atthorv/Sensobar-48HD_6L/slave_board/Project Outputs for Netscale48HD_Sensorbar/BOM_S.xls

Designator | Value | Description | Manufacturer PartNr | Footprint/Package | Replaceable | Quantity
C1, C3, C5, C7, C9, C21 | 10nF | 10000pF ±10% 50V Keramikkondensatoren X7R 0402 (1005 metrisch) CL05B103KB5NNNC | CL05B103KB5NNNC | '0402 | yes | 6
C2, C4, C6, C8, C10, C19, C20 | 2.2uF | Multilayer Ceramic Capacitors MLCC - SMD/SMT 0402 2.2uF 6.3volts *Derate Voltage/Temp, 2.2µF ±20% 25V Ceramic Capacitor X5R 0402 (1005 Metric), Multilayer Ceramic Capacitors MLCC - SMD/SMT 0402 2.2uF 6.3volts | GRM155R60J225ME15D | 0402 | yes | 7
C11 | 10pF | Multilayer Ceramic Capacitors MLCC - SMD/SMT 0402 10pF 50Volts C0G 1% | GJM1555C1H100FB01D | '0402 | yes | 1
C12, C16, C17 | 3.3nF | Multilayer Ceramic Capacitors MLCC - SMD/SMT 0402 3300pF 50volts X7R 5% | GCM155R71H332JA37D | '0402 | yes | 3
C13, C14 | 15pF | Multilayer Ceramic Capacitors MLCC - SMD/SMT 0402 15pF 50Volts C0G 5%, Multilayer Ceramic Capacitors MLCC | GJM1555C1H150FB01D | '0402 | yes | 2
C15, C18 | 1.2nF | Multilayer Ceramic Capacitors MLCC - SMD/SMT 50V 1200pF C0G 0402 5% | C0402C122J5GACTU | '0402 | yes | 2
C28_A, C28_B, C28_C, C30_A, C30_B, C30_C | 100nF | 0.1µF ±10% 10V Ceramic Capacitor X5R 0402 (1005 Metric) | LMK105BJ104KV-F | '0402 | yes | 6
C31_A, C31_B, C31_C, C32_A, C32_B, C32_C, C37_A, C37_B, C37_C, C39_A, C39_B, C39_C, C46_A, C46_B, C46_C, C53_A, C53_B, C53_C, C60_A, C60_B, C60_C, C67_A, C67_B, C67_C | 220pF | 220pF ±1% 50V Ceramic Capacitor C0G, NP0 0402 (1005 Metric) | GRM033R71E122KA01D | '0402 | yes | 24
C33_A, C33_B, C33_C, C35_A, C35_B, C35_C, C38_A, C38_B, C38_C, C42_A, C42_B, C42_C, C49_A, C49_B, C49_C, C56_A, C56_B, C56_C, C63_A, C63_B, C63_C, C70_A, C70_B, C70_C | 150pF | 150pF ±1% 50V Ceramic Capacitor C0G, NP0 0402 (1005 Metric) | GRM1555C1H151FA01D | '0402 | yes | 24
C34_A, C34_B, C34_C, C36_A, C36_B, C36_C, C40_A, C40_B, C40_C, C43_A, C43_B, C43_C, C50_A, C50_B, C50_C, C57_A, C57_B, C57_C, C64_A, C64_B, C64_C, C71_A, C71_B, C71_C | 4.7pF | 4.7pF ±0.05pF 50V Ceramic Capacitor C0G, NP0 0402 (1005 Metric) | GJM1555C1H4R7WB01D | '0402 | yes | 24
FB1 |  | FERRITE BEAD 1 KOHM 0402 1LN | BK1005HS102-T | '0402 | no | 1
J3 |  | Connector,Board to Board,DF12 Hirose DF12 Series 0.5mm 20 Way 2 Row Straight PCB Socket Surface Mount Board to Board | DF12-20DS-0.5V(86) |  | no | 1
L1, L2 | 100nH | 100nH Unshielded Multilayer Inductor 300mA 100 mOhm Max 0603 (1608 Metric) | HK1608R10J-T | 0603 | no | 2
LED1_A, LED1_B, LED1_C, LED2_A, LED2_B, LED2_C, LED3_A, LED3_B, LED3_C, LED4_A, LED4_B, LED4_C, LED5_A, LED5_B, LED5_C, LED6_A, LED6_B, LED6_C, LED7_A, LED7_B, LED7_C, LED8_A, LED8_B, LED8_C |  | Red 630nm LED Indication - Discrete 1.95V 2-SMD, No Lead | APA1606SURCK | 0402 | yes | 24
R1, R2, R3 | 1K | RES SMD 1K OHM 1% 1/16W 0402 | RC0402FR-071KL | 0402 | yes | 3
R4, R5 | 10K | SMD 10K ohm 1% 50V General Purpose | RC0402FR-1010KL | 0402 | yes | 2
R6_A, R6_B, R6_C, R7_A, R7_B, R7_C, R10_A, R10_B, R10_C, R11_A, R11_B, R11_C, R12_A, R12_B, R12_C, R13_A, R13_B, R13_C, R14_A, R14_B, R14_C, R15_A, R15_B, R15_C | 68R | 68 Ohms ±1% 0.125W, 1/8W Chip Resistor 0402 (1005 Metric) Pulse Withstanding Thick Film | CRGP0402F68R | 0402 | yes | 24
R8_A, R8_B, R8_C, R9_A, R9_B, R9_C, R17_A, R17_B, R17_C, R19_A, R19_B, R19_C, R21_A, R21_B, R21_C, R23_A, R23_B, R23_C, R25_A, R25_B, R25_C, R27_A, R27_B, R27_C | 620 | 620 Ohms ±1% 0.1W, 1/10W Chip Resistor 0402 (1005 Metric) Automotive AEC-Q200 Thick Film | ERJ-2RKF6200X | 0402 | yes | 24
U1 |  | TRF7960ARHBT | TRF7960ARHBT |  | no | 1
U3_A, U3_B, U3_C |  | IC 8BIT SHIFT REGISTER 16HVQFN | 74AHC595BQ,115 |  | no | 3
U4_A, U4_B, U4_C |  | Multiplexer Switch ICs Sngl-Pole Dbl-Throw Analog Switch | SN74CBTLV3251RGYR | VQFN-16 | no | 3
U5_A, U5_B, U5_C, U6_A, U6_B, U6_C, U7_A, U7_B, U7_C, U9_A, U9_B, U9_C, U11_A, U11_B, U11_C, U13_A, U13_B, U13_C, U15_A, U15_B, U15_C, U17_A, U17_B, U17_C |  | antenna |  |  | no | 24
Y1 |  | 13.56MHz ±10ppm Crystal 12pF 150 Ohms 4-SMD, No Lead | CX2520DB13560H0FLJC1 |  | no | 1
