atthorv/Sensobar-48HD_6L/master_board/Project Outputs for Netscale48HD_Sensorbar/BOM_M.xls

Designator | Value | Description | Manufacturer PartNr | Footprint/Package | Replaceable | Quantity
C1, C3, C5, C7, C9, C21 | 10nF | 10000pF ±10% 50V Keramikkondensatoren X7R 0402 (1005 metrisch) CL05B103KB5NNNC | CL05B103KB5NNNC | 0402 | yes | 6
C2, C4, C6, C8, C10, C22, C59, C85, C86, C87 | 2.2uF | Multilayer Ceramic Capacitors MLCC - SMD/SMT 0402 2.2uF 6.3volts *Derate Voltage/Temp, 2.2µF ±20% 25V Ceramic Capacitor X5R 0402 (1005 Metric) | GRM155R60J225ME15D | 0402 | yes | 10
C11 | 10pF | Multilayer Ceramic Capacitors MLCC - SMD/SMT 0402 10pF 50Volts C0G 1% | GJM1555C1H100FB01D | 0402 (1005 metric) | yes | 1
C12, C16, C17 | 3.3nF | Multilayer Ceramic Capacitors MLCC - SMD/SMT 0402 3300pF 50volts X7R 5% | GCM155R71H332JA37D | 0402 (1005 metric) | yes | 3
C13, C14, C54, C55 | 15pF | Multilayer Ceramic Capacitors MLCC - SMD/SMT 0402 15pF 50Volts C0G 5%, Multilayer Ceramic Capacitors MLCC | GJM1555C1H150FB01D | 0402 | no | 4
C15, C18 | 1.2nF | Multilayer Ceramic Capacitors MLCC - SMD/SMT 50V 1200pF C0G 0402 5% | C0402C122J5GACTU | 0402 (1005 metric) | yes | 2
C19, C20, C23, C24, C25, C27, C29, C44, C51, C52, C58, C62, C66, C76, C77, C78, C79, C80, C81, C82, C83, C88 | 0.1uF | SMD/SMT WCAP-CSGP 0.1uF 0402 20% 10V MLCC | 885012105010 | 0402 | yes | 22
C26 | 0.1uF | SMD/SMT WCAP-CSGP 0.1uF 0402 20% 10V MLCC | 885012105010 | 0402 | yes | 1
C28_A, C28_B, C28_C, C30_A, C30_B, C30_C | 100nF | 0.1µF ±10% 10V Ceramic Capacitor X5R 0402 (1005 Metric) | LMK105BJ104KV-F | 0402 | yes | 6
C31_A, C31_B, C31_C, C32_A, C32_B, C32_C, C37_A, C37_B, C37_C, C39_A, C39_B, C39_C, C46_A, C46_B, C46_C, C53_A, C53_B, C53_C, C60_A, C60_B, C60_C, C67_A, C67_B, C67_C | 220pF | 220pF ±1% 50V Ceramic Capacitor C0G, NP0 0402 (1005 Metric) | GRM033R71E122KA01D | 0402 | yes | 24
C33_A, C33_B, C33_C, C35_A, C35_B, C35_C, C38_A, C38_B, C38_C, C42_A, C42_B, C42_C, C49_A, C49_B, C49_C, C56_A, C56_B, C56_C, C63_A, C63_B, C63_C, C70_A, C70_B, C70_C | 150pF | 150pF ±1% 50V Ceramic Capacitor C0G, NP0 0402 (1005 Metric) | GRM1555C1H151FA01D | 0402 | yes | 24
C34_A, C34_B, C34_C, C36_A, C36_B, C36_C, C40_A, C40_B, C40_C, C43_A, C43_B, C43_C, C50_A, C50_B, C50_C, C57_A, C57_B, C57_C, C64_A, C64_B, C64_C, C71_A, C71_B, C71_C | 4.7pF | 4.7pF ±0.05pF 50V Ceramic Capacitor C0G, NP0 0402 (1005 Metric) | GJM1555C1H4R7WB01D | 0402 | yes | 24
C41, C45 | 1uF | SMD/SMT 0402 1uF 10volts X7S 10% | GCM155C71A105KE38D | 0402 (1005 metric) | yes | 2
C47, C48 | 11pF | SMD/SMT 0402 11pF 50volts C0G 5% | GRM1555C1H110JA01D | 0402 | yes | 2
C61 | 1nF | 1000pF ±20% 50V Ceramic Capacitor X5R 0402 (1005 Metric) | C1005X5R1H102M050BA | 0402 | yes | 1
C65 | 10uF | Multilayer Ceramic Capacitors MLCC - SMD/SMT | ZRB15XR61A106ME01D | 0402 | yes | 1
C68, C69 | 470nF | 470nF, 100V, X7R, 10 %, Chip Monolithic Ceramic Capacitor for General, 0805 (metric 2012) | GRM21BR72A474KA73L | 0805 | yes | 2
C72 | 10uF | Chip Capacitor, 10 uF, +/- 20%, 100 V, -55 to 125 degC, 2220 (5750 Metric), RoHS, Tape and Reel |  | 2220 |  | 1
C73 | 100uF | Multilayer Ceramic Capacitors MLCC - SMD/SMT 1210 100uF 10volts *Derate Voltage/Temp | GRM32ER61A107ME20L | 1210 | yes | 1
C75, C84 | 4.7uF | SMD/SMT 0603 4.7uF 10volts | GRM188R61A475KE15D | 0603 | yes | 2
D1 | SMAJ51A | ESD Suppressors / TVS Diodes 51volts 5uA 4.9 Amps Uni-Dir | SMAJ51A | DO-214AC-2 (SMA) | yes | 1
D4, D5 |  | Thyristor Surge Protection Devices (TSPD) PxxxxS4xLRP Series SIDACtor Protection Thyristor 100A 25V Bi SOD | P0080S4BLRP | SOD-123FL | no | 2
D6 | CDSOT23-SM712 | Surface Mount TVS Diode, 17 A Ipp, -55 to 150 degC, 3-Pin SOT23, RoHS, Tape and Reel |  | DO-214AC-2 (SMA) | no | 1
D7 |  | 15MQ060N SCHOTTKY RECTIFIER | 15MQ060N |  |  | 1
FB1 |  | FERRITE BEAD 1 KOHM 0402 1LN | BK1005HS102-T |  |  | 1
J1 |  | Headers & Wire Housings 6P 1.27MM SNGL ROW R/A MALE BLK | 214013 | 1.27mm | no | 1
J2 |  | Connector,Board to Board,DF12 Hirose DF12 Series, 0.5mm Pitch 20 Way 2 Row Straight PCB Header, Solder Termination, 0.3A |  |  | no | 1
L1, L2 | 100nH | 100nH Unshielded Multilayer Inductor 300mA 100 mOhm Max 0603 (1608 Metric) | HK1608R10J-T | 0603 | yes | 2
L5, L6, L7, L8 |  | Chip Ferrite Bead | BLM18KG601SN1D |  | no | 4
L9 | 600R(Z) | Ferritperlen MULTILYR CHP BD 0603 600OHMS 25% | BK1608HS601-T | 0603 | yes | 1
L10 |  | 6.8uH, WE-MAIA SMD Power Inductor | 78438357068 |  |  | 1
LED1_A, LED1_B, LED1_C, LED2_A, LED2_B, LED2_C, LED3_A, LED3_B, LED3_C, LED4_A, LED4_B, LED4_C, LED5_A, LED5_B, LED5_C, LED6_A, LED6_B, LED6_C, LED7_A, LED7_B, LED7_C, LED8_A, LED8_B, LED8_C |  | Red 630nm LED Indication - Discrete 1.95V 2-SMD, No Lead | APA1606SURCK |  | no | 24
LED9 |  | blue, 1.6 x 0.6 mm Right Angle SMD Chip LED Lamp | APA1606VBC/D | specific, see datasheet | yes | 1
P1 |  | 20Pin, 2Rows, side/horizontally, MICRO LOW-PROFILE TERMINAL STRIPS | FTSH-110-01-F-DH | 1.27 mm | no | 1
P2 |  | 6Pin, 2Rows, MICRO LOW-PROFILE TERMINAL STRIPS | FTSH-103-01-F-DH | 1.27 mm | no | 1
P3, P4 |  | Segger, J-Link 10-pin Needle Adapter |  |  | no | 2
P5 |  | Pad_1mmx2mm | Pad_1mmx2mm |  | no | 1
R1, R2, R3 | 1K | RES SMD 1K OHM 1% 1/16W 0402 | RC0402FR-071KL | 0402 | yes | 3
R4 | DNP | Resistor: do not populate | do not populate | 0402 | no | 1
R5 | 10K | 10K 0.063W 1% 0402 (1005 Metric) SMD | RC0402FR-0710KL | 0402 | yes | 1
R6_A, R6_B, R6_C, R7_A, R7_B, R7_C, R10_A, R10_B, R10_C, R11_A, R11_B, R11_C, R12_A, R12_B, R12_C, R13_A, R13_B, R13_C, R14_A, R14_B, R14_C, R15_A, R15_B, R15_C | 68R | 68 Ohms ±1% 0.125W, 1/8W Chip Resistor 0402 (1005 Metric) Pulse Withstanding Thick Film | CRGP0402F68R | 0402 | yes | 24
R8_A, R8_B, R8_C, R9_A, R9_B, R9_C, R17_A, R17_B, R17_C, R19_A, R19_B, R19_C, R21_A, R21_B, R21_C, R23_A, R23_B, R23_C, R25_A, R25_B, R25_C, R27_A, R27_B, R27_C | 620 | 620 Ohms ±1% 0.1W, 1/10W Chip Resistor 0402 (1005 Metric) Automotive AEC-Q200 Thick Film | ERJ-2RKF6200X | 0402 | yes | 24
R16, R30, R32 | 0R | 0 Ohms Resistor 0402, 0 Ohms Jumper 0.1W, 1/10W Chip Resistor 0402 (1005 Metric) Automotive AEC-Q200 Thick Film | ERJ-2GE0R00X | 0402 (1005 metric) | yes | 3
R18, R35 | 1K | Thick Film Resistors - SMD CRGCQ 0402 1K0 1% SMD Resistor | CRGCQ0402F1K0 | 0402 (1005 metric) | yes | 2
R20, R22, R24, R26, R28, R33, R41, R42 | 10K | SMD 10K ohm 1% 50V General Purpose | RC0402FR-1010KL | 0402 | yes | 8
R29, R34 | 10 | 10R, Pulse Proof, High Power Thick Film Chip Resistors | CRCW060310R0FKEAHP | 0603 |  | 2
R31 | 120R | 120 Ohms ±1% 0.063W, 1/16W Chip Resistor 0402 (1005 Metric) Automotive AEC-Q200, Moisture Resistant Thick Film | CRGCQ0402F120R | 0402 | yes | 1
R36 | 60K4 | 60.4 kOhms ±1% 0.063W, 1/16W Chip Resistor 0402 (1005 Metric) Moisture Resistant Thick Film | RC0402FR-0760K4L | 0402 |  | 1
R38 | 100K | 100 kOhm Resistor 0402 | CRCW0402100KJNEDC | 0402 | yes | 1
R39 | 51R | Resistor | RC0402JR-0751RL | 0402 | yes | 1
R40 | 620R | SMD 1/16W 620ohm 0.5% | RR0510P-621-D | 0402 | yes | 1
TVS1 | TBU-PL060-200-WH | TBU-PL Series dual 50 ohm Surge Suppressors, bi-directional | TBU-PL060-200-WH | DFN | no | 1
U1 |  | TRF7960ARHBT | TRF7960ARHBT |  |  | 1
U2 |  | STM32 Dynamic Efficiency MCU with BAM, High-performance and DSP with FPU, ARM Cortex-M4 MCU with 512 Kbytes Flash, 100 MHz CPU, Art Accelerator, DFSDM | STM32F412VEH6 | UFBGA-100 | no | 1
U3_A, U3_B, U3_C |  | IC 8BIT SHIFT REGISTER 16HVQFN | 74AHC595BQ,115 |  | no | 3
U4_A, U4_B, U4_C |  | Multiplexer Switch ICs Sngl-Pole Dbl-Throw Analog Switch | SN74CBTLV3251RGYR | VQFN-16 | no | 3
U5_A, U5_B, U5_C, U6_A, U6_B, U6_C, U7_A, U7_B, U7_C, U9_A, U9_B, U9_C, U11_A, U11_B, U11_C, U13_A, U13_B, U13_C, U15_A, U15_B, U15_C, U17_A, U17_B, U17_C |  | antenna |  |  | no | 24
U8 |  | AT91 ARM Cortex-M4 32-bit Microcontroller, 1MB Flash, 128KB SRAM, USB, 79 User I/Os, 64-Pin QFN, Industrial Grade (-40°C to 105°C), Pb-Free | ATSAM4S16BA-MU | QFN, 64-Leads, Body 9x9mm, Pitch 0.5mm, Thermal Pad 7.5x7.5mm, IPC Medium Density | no | 1
U10 |  | 1/1 Transceiver Half RS422, RS485 8-SOIC | SN65HVD11DR | 8-SOIC | no | 1
U12 |  | Buffer, Non-Inverting 1 Element 1 Bit per Element 3-State Output SOT-353 | 74AHC1G125SE-7 | SOT353 | no | 1
U14 |  | 55V, 1.2A Step-Down Regulator with 2.8μA Quiescent Current | LT3991EMSE-3.3#PBF |  | no | 1
Y1 |  | 13.56MHz ±10ppm Crystal 12pF 150 Ohms 4-SMD, No Lead | CX2520DB13560H0FLJC1 |  | no | 1
Y2 |  | Quarz 24MHz-10pF 10ppm-10C +70C | ECS-240-10-36-CKL-TR | specific, see datasheet | no | 1
Y3 |  | 12MHz ±20ppm Crystal 18pF 60 Ohms 2-SMD, No Lead | ABM3-12.000MHZ-B2-T | 2-SMD | no | 1
