atthorv/Sensobar-48HD_6L/slave_board/Project Outputs for Netscale48HD_Sensorbar/Schematic_S.PDF

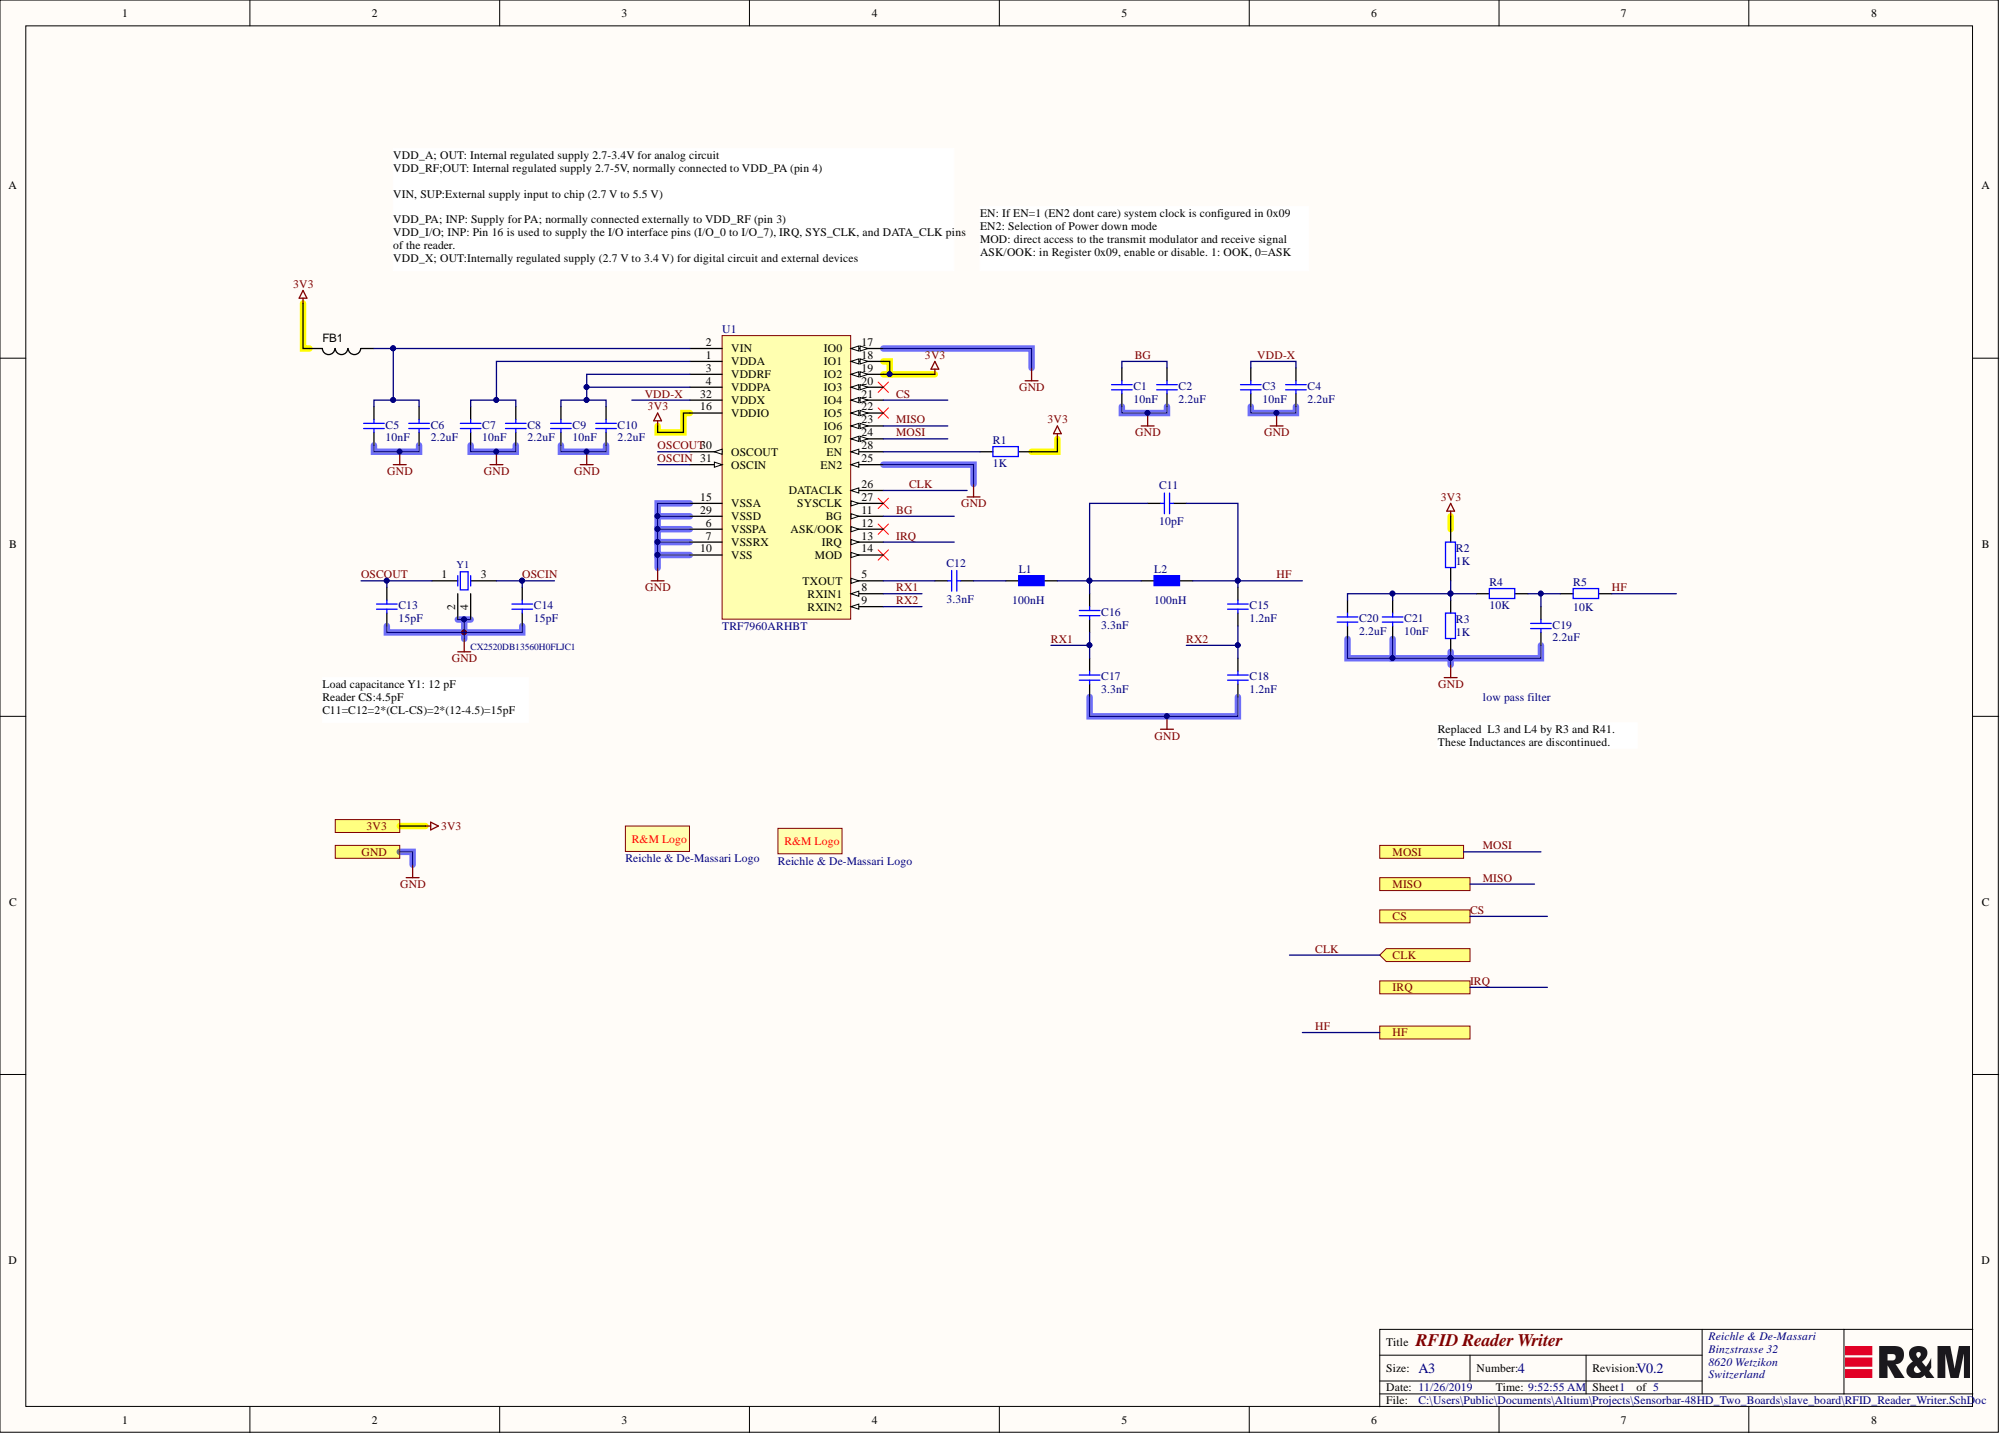
[picture p1: page 1]

VDD_A; OUT: Internal regulated supply 2.7-3.4V for analog circuit
VDD_RF;OUT: Internal regulated supply 2.7-5V, normally connected to VDD_PA (pin 4)

VIN, SUP:External supply input to chip (2.7 V to 5.5 V)

VDD_PA; INP: Supply for PA; normally connected externally to VDD_RF (pin 3)
VDD_I/O; INP: Pin 16 is used to supply the I/O interface pins (I/O_0 to I/O_7), IRQ, SYS_CLK, and DATA_CLK pins
of the reader.
VDD_X; OUT:Internally regulated supply (2.7 V to 3.4 V) for digital circuit and external devices

EN: If EN=1 (EN2 dont care) system clock is configured in 0x09
EN2: Selection of Power down mode
MOD: direct access to the transmit modulator and receive signal
ASK/OOK: in Register 0x09, enable or disable. 1: OOK, 0=ASK

VDDPA 4

VDDX 32 | GND VDD-X

VDDIO 16

Replaced L3 and L4 by R3 and R41.
These Inductances are discontinued.

R&M Logo
Reichle & De-Massari Logo

RFID Reader Writer Title | Reichle & De-Massari Binzstrasse 32 8620 Wetzikon Switzerland

Size: A3 | Number: 4 | Revision: V0.2
Date: 11/26/2019 Time: 9:52:55 AM | | Sheet of

C:\Users\Public\Documents\Altium\Projects\Sensorbar-48HD_Two_Boards\slave_board\RFID_Reader_Writer.SchDoc

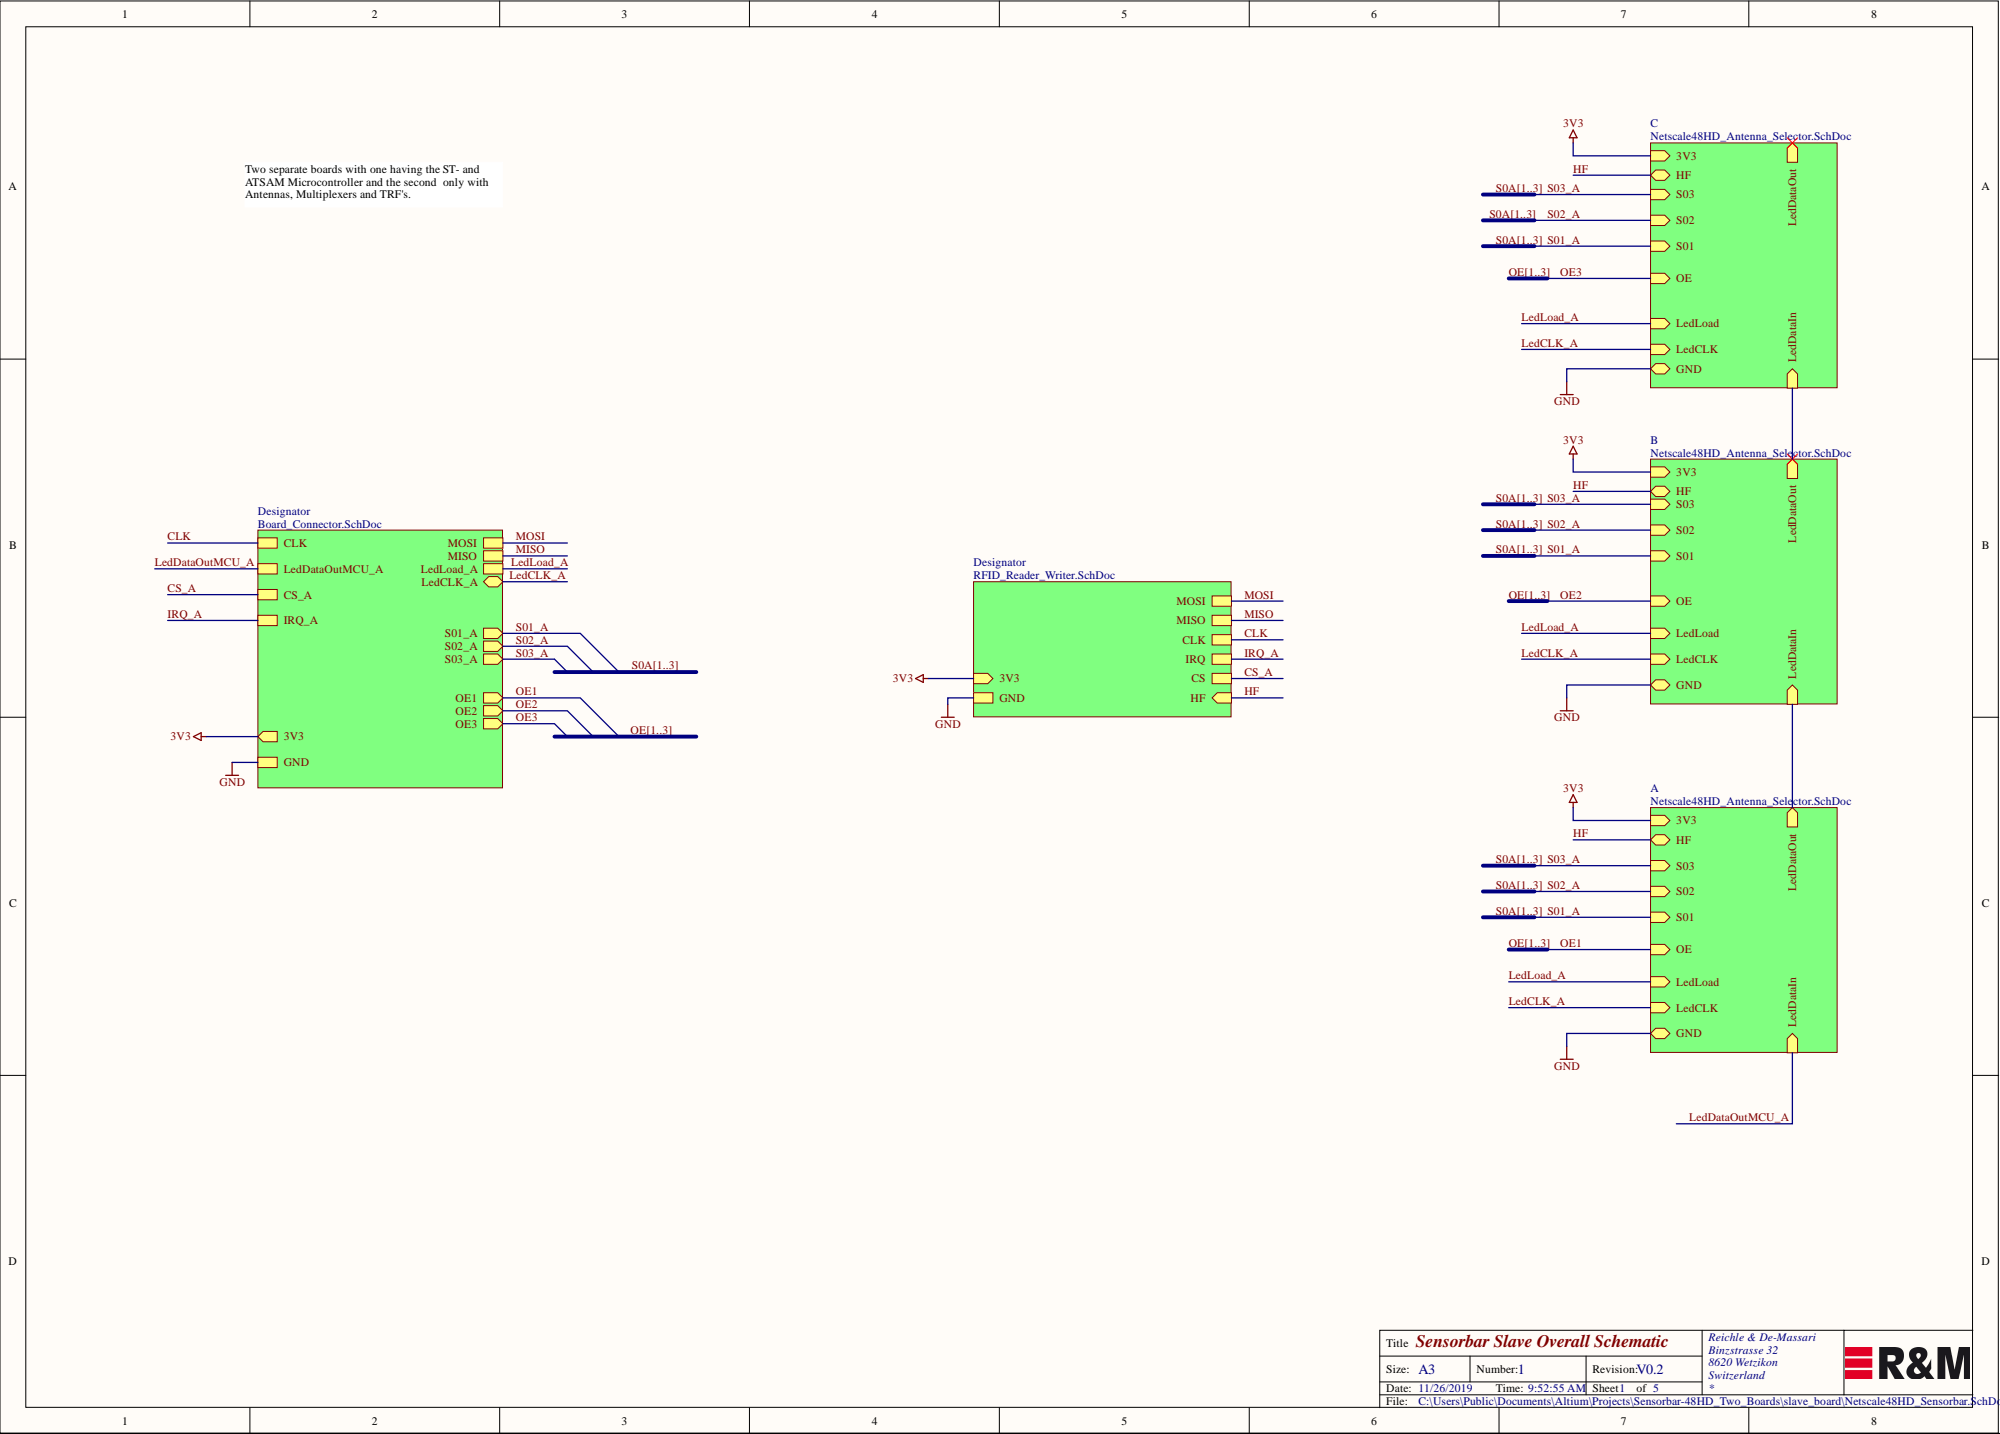
[picture p2: page 2]

Sensorb T e | Reich le & De-Ma s a r i B n z t se 3 0 Wetz iko Swi tzer l d *

Size: | N umber: | Rev

/ ime: : A M | | Sheet f

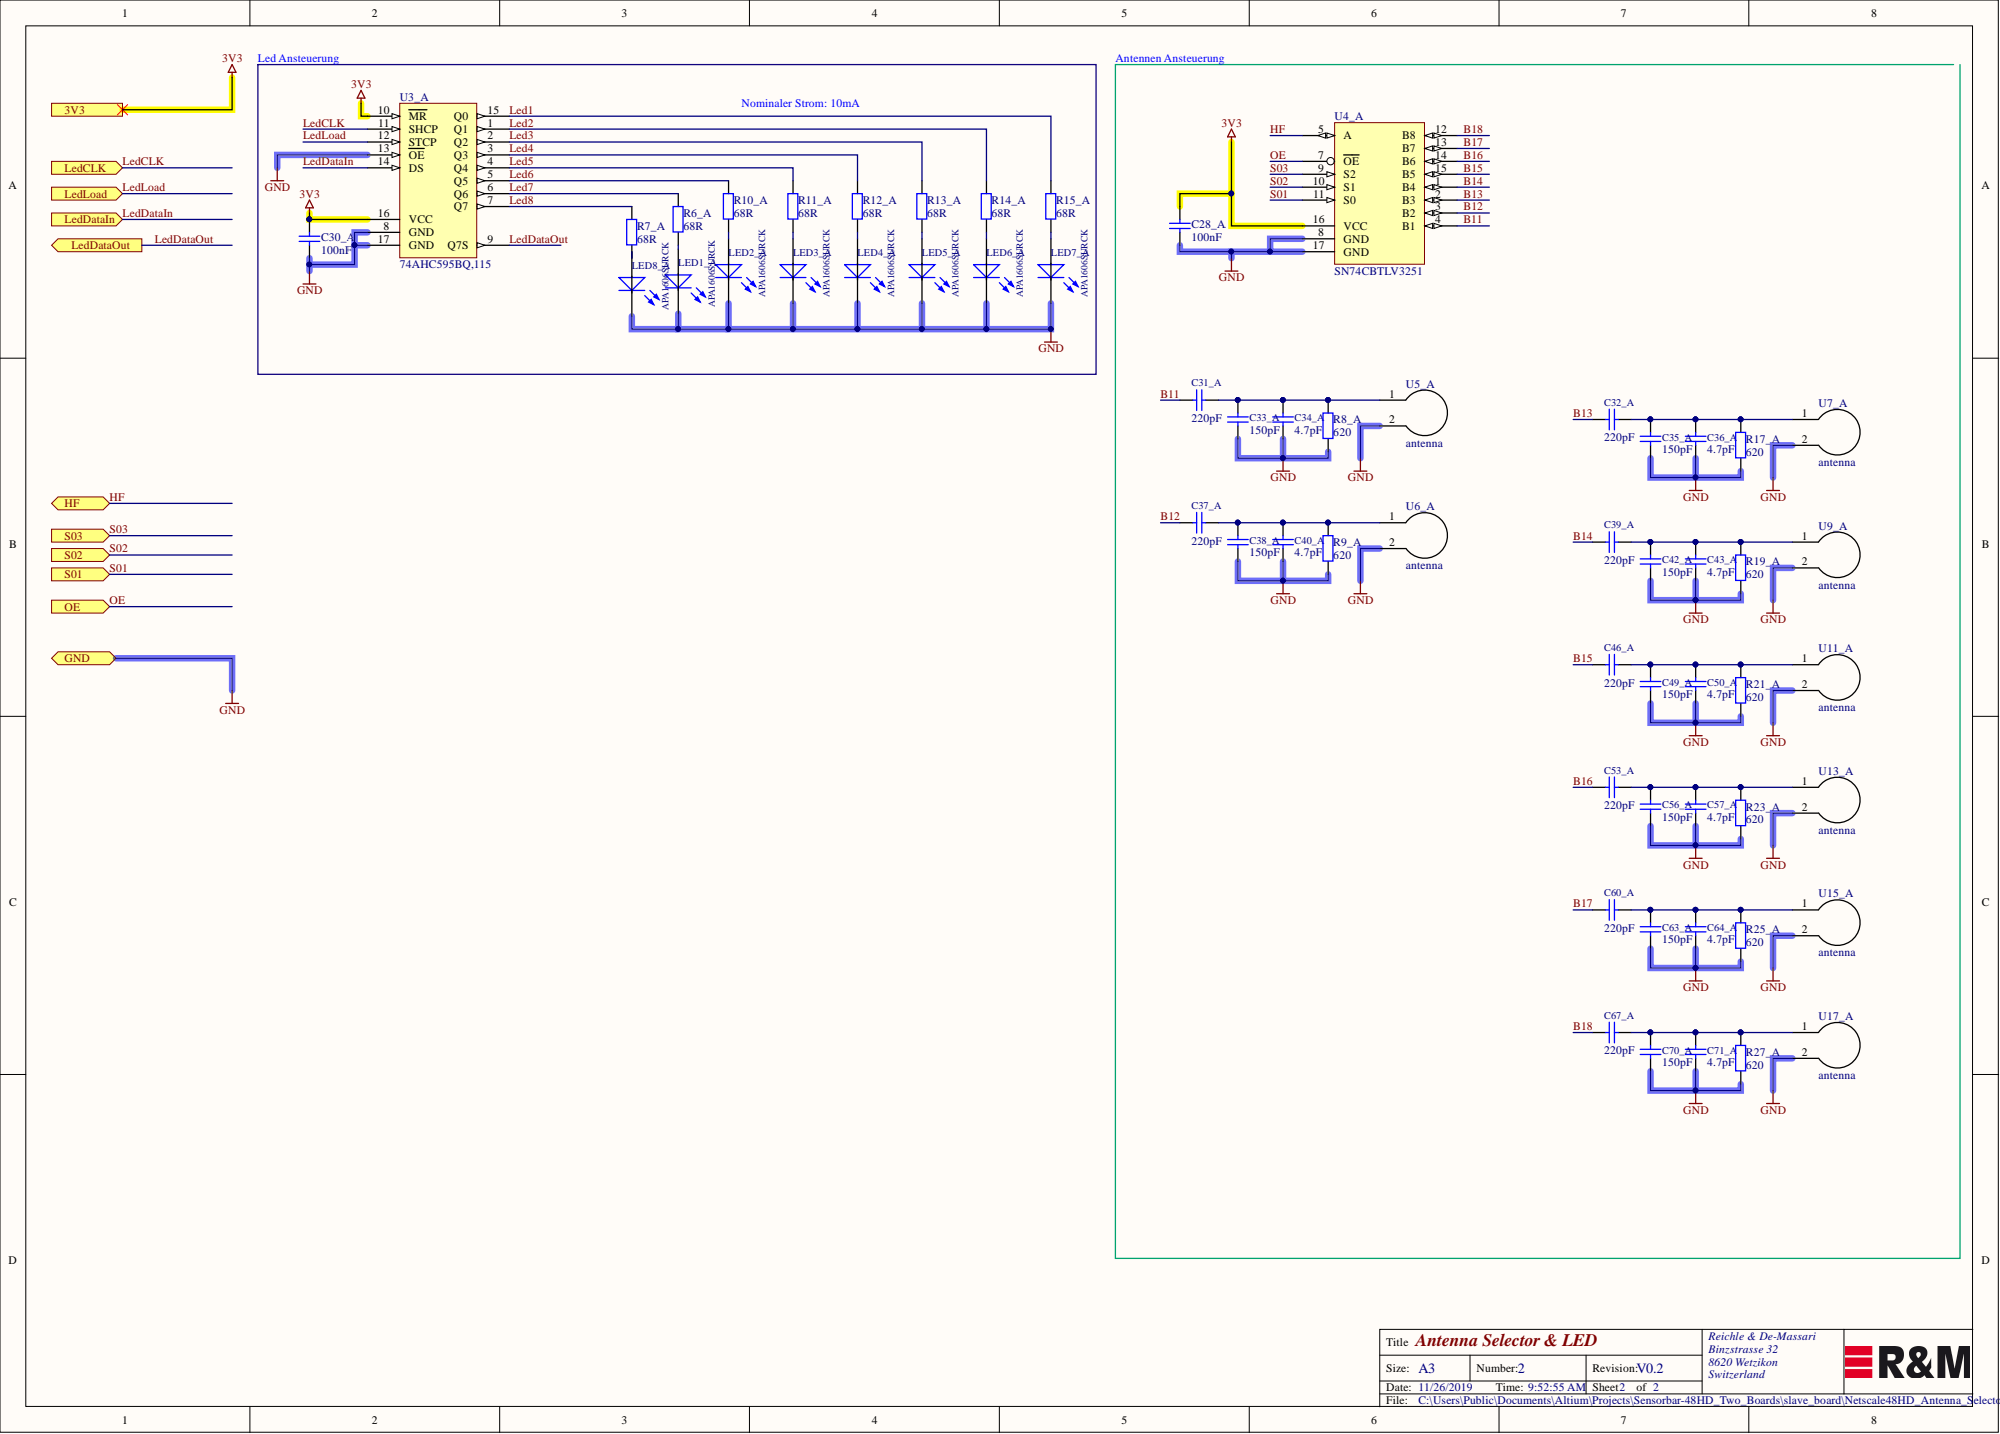
[picture p3: page 3]

Led DataIn | 1 4 | | 4 | Led 5
V 3 1 6 | | 5 | Led 6

6 Led 7

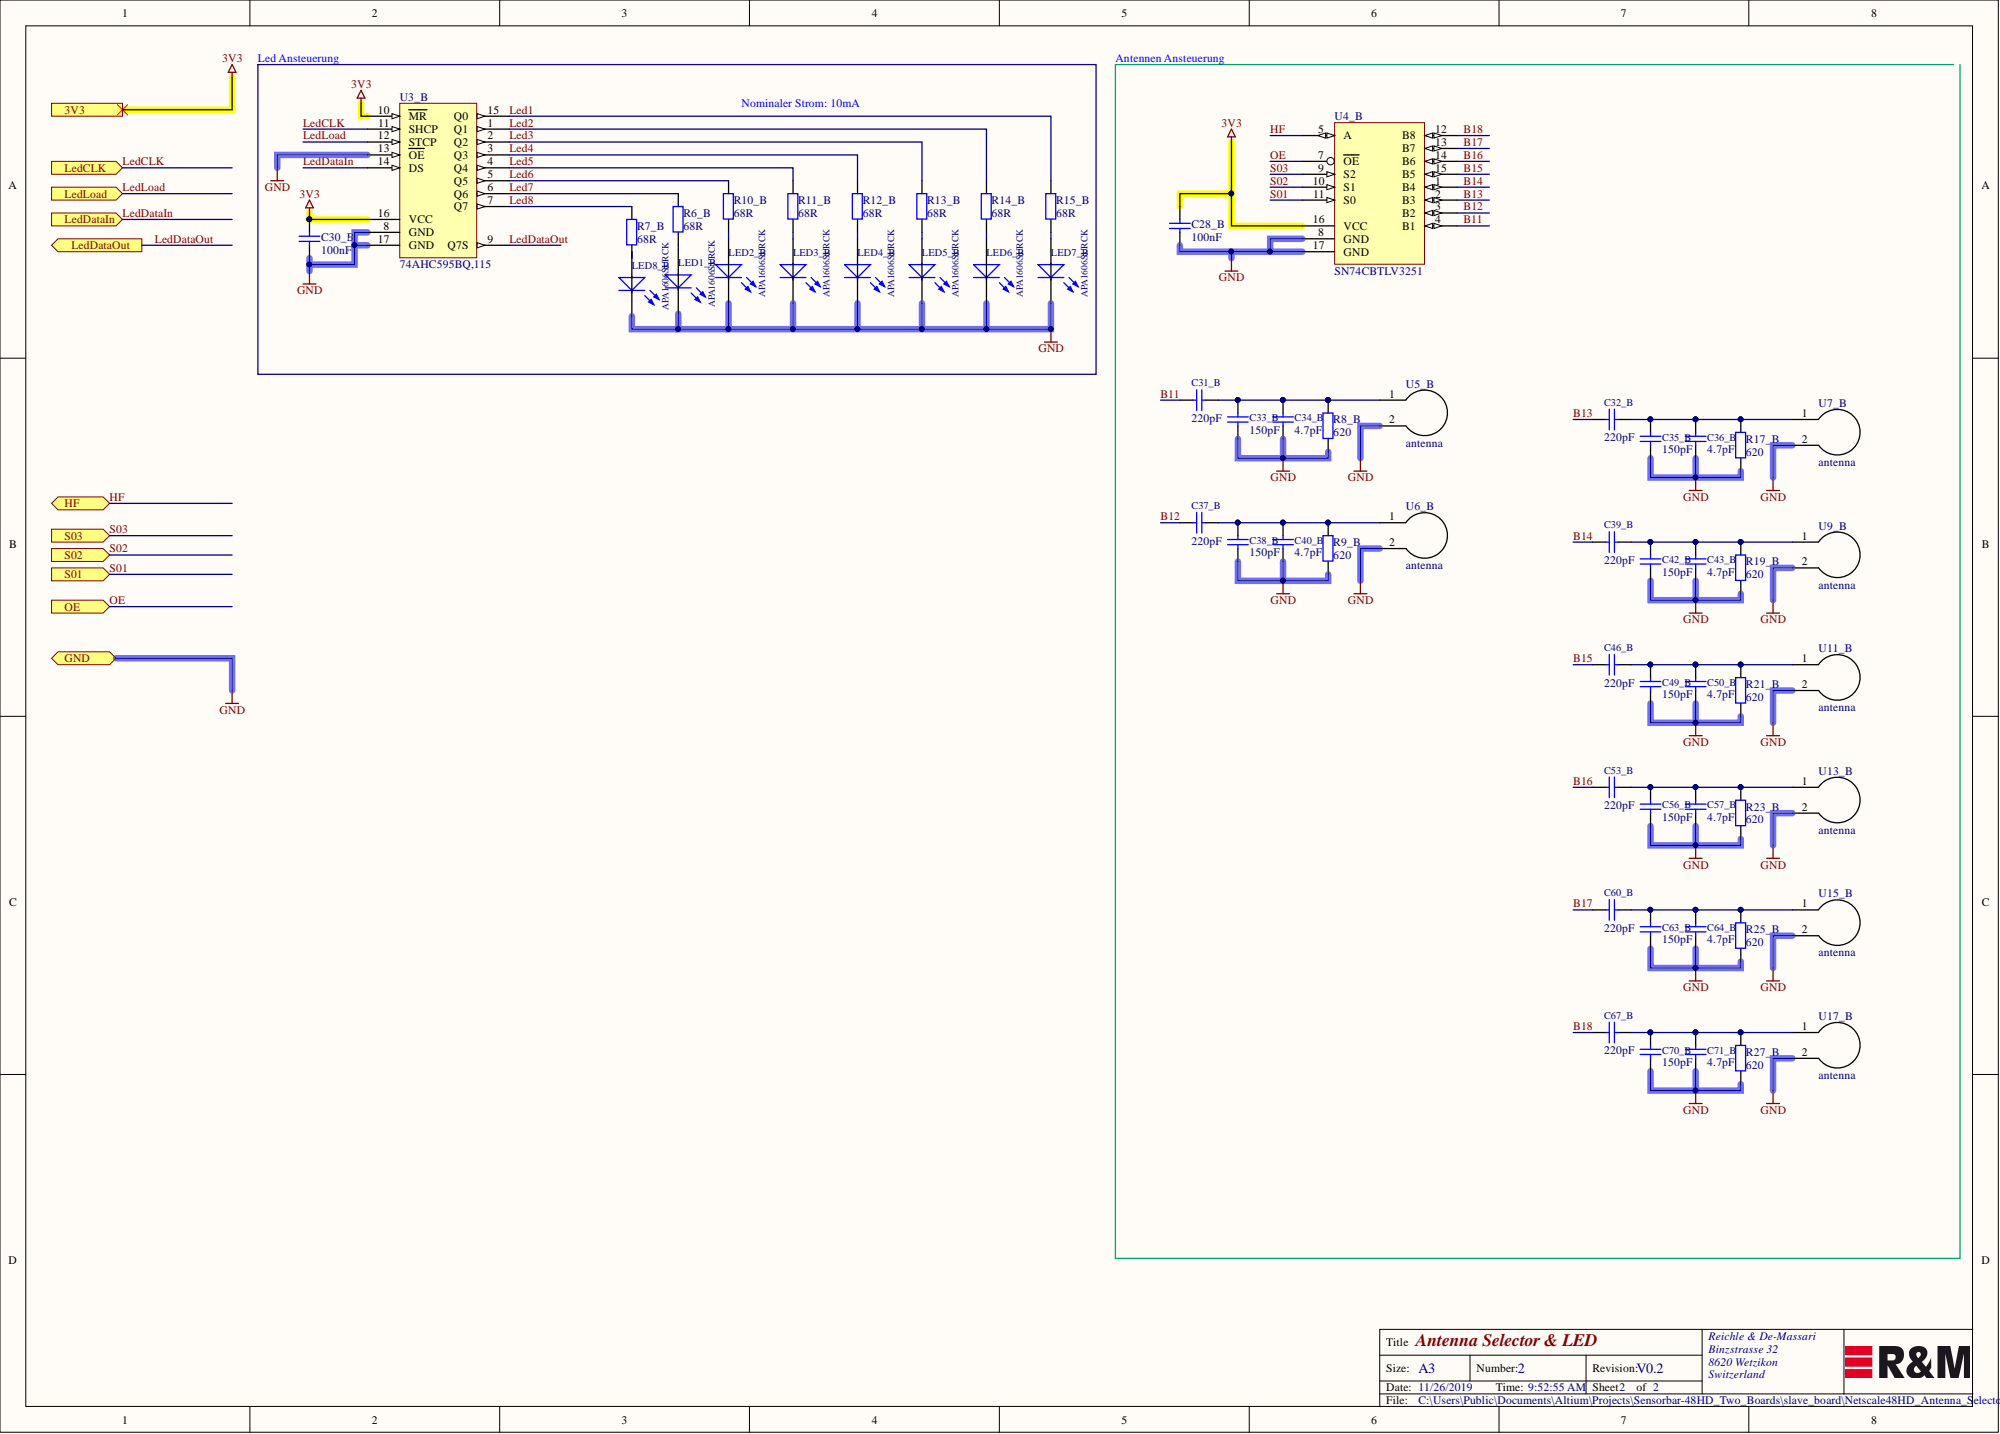
[picture p4: page 4]

Led DataIn | 1 4 | | 4 | Led 5
V 3 1 6 | | 5 | Led 6

6 Led 7

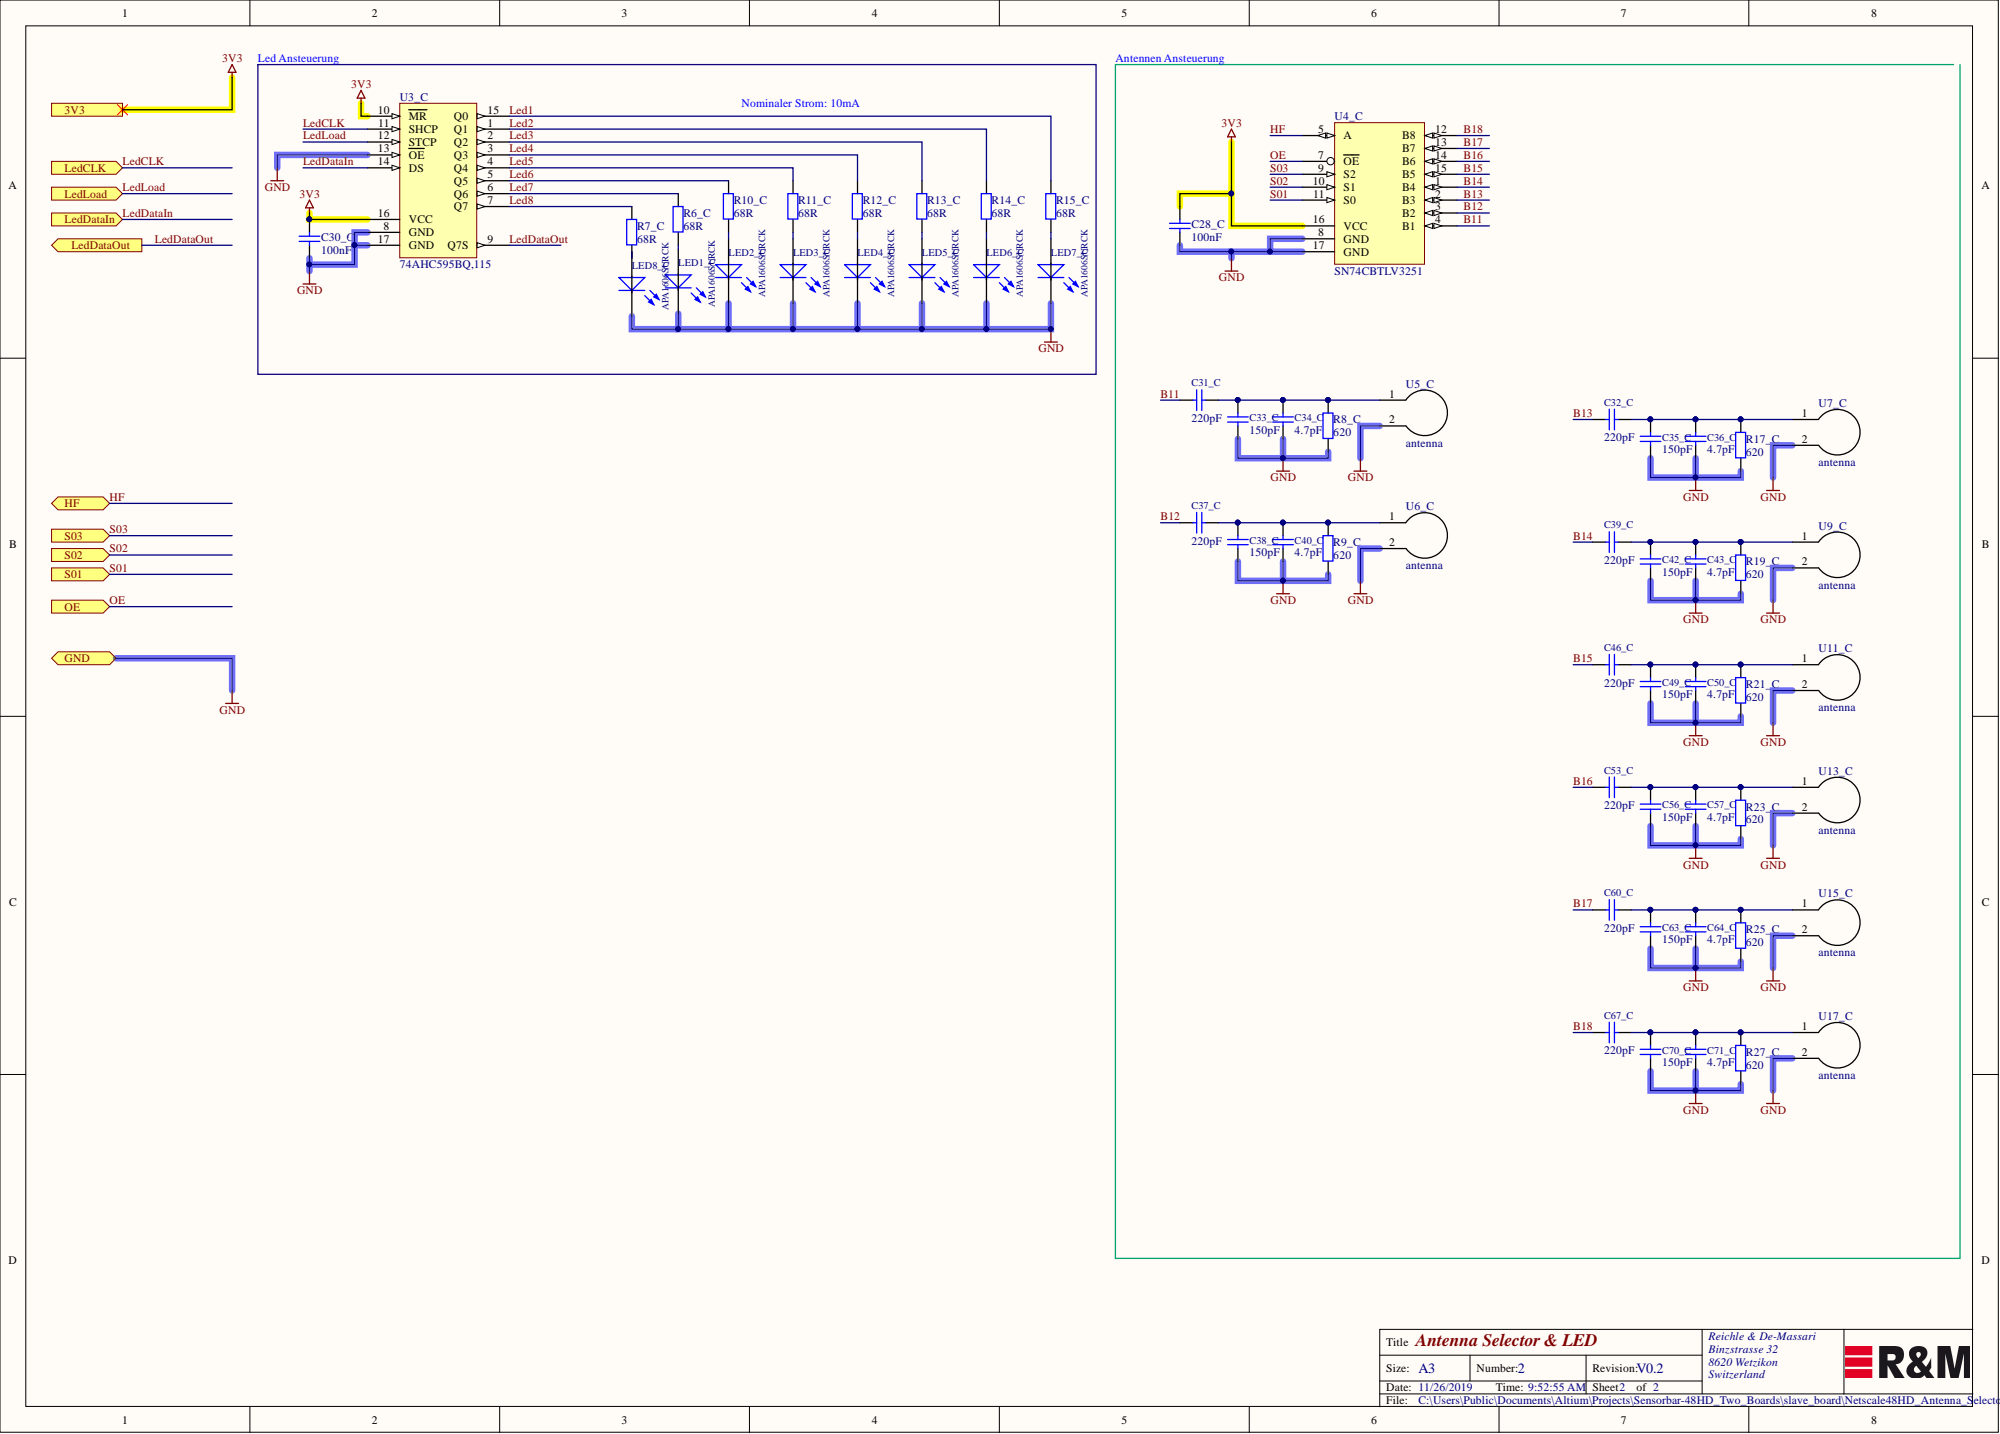
[picture p5: page 5]

Led DataIn | 1 4 | | 4 | Led 5
V 3 1 6 | | 5 | Led 6

6 Led 7

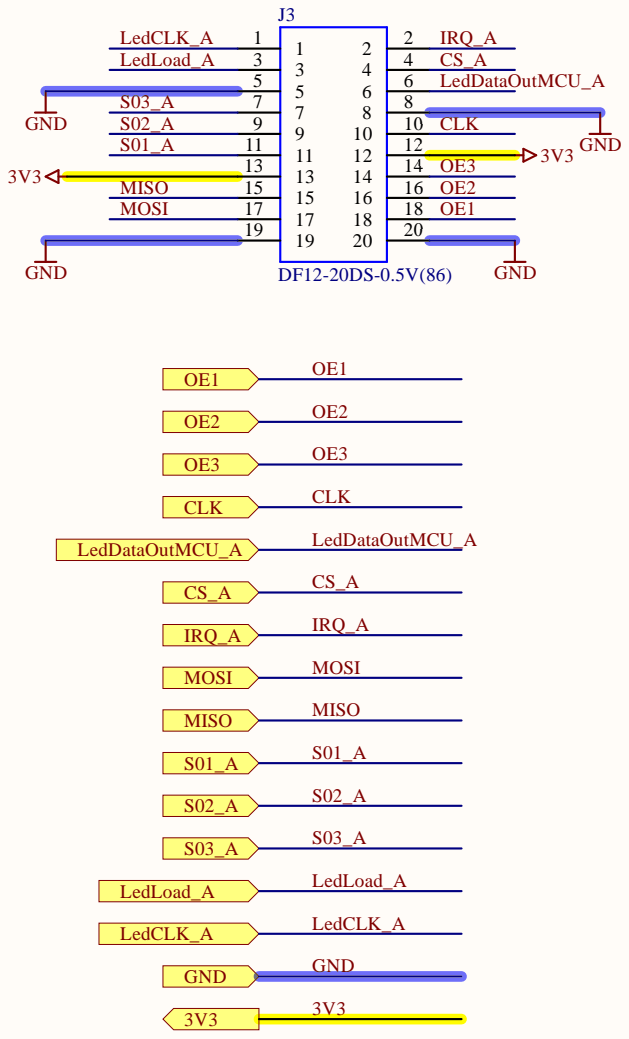
[picture p6: page 6]

Board_Connector Title | Reichle & De-Massari Binzstrasse 32 8620 Wetzikon Switzerland *

Size: A3 | Number: 5 | Revision: V0.2
11/26/2019 Time: 9:52:55 AM | | Sheet of 5

C:\Users\Public\Documents\Altium\Projects\Sensorbar-48HD_Two_Boards\slave_board\Board_Connector.SchDoc
