atthorv/Sensobar-48HD_6L/master_board/Project Outputs for Netscale48HD_Sensorbar/Schematics_M.PDF

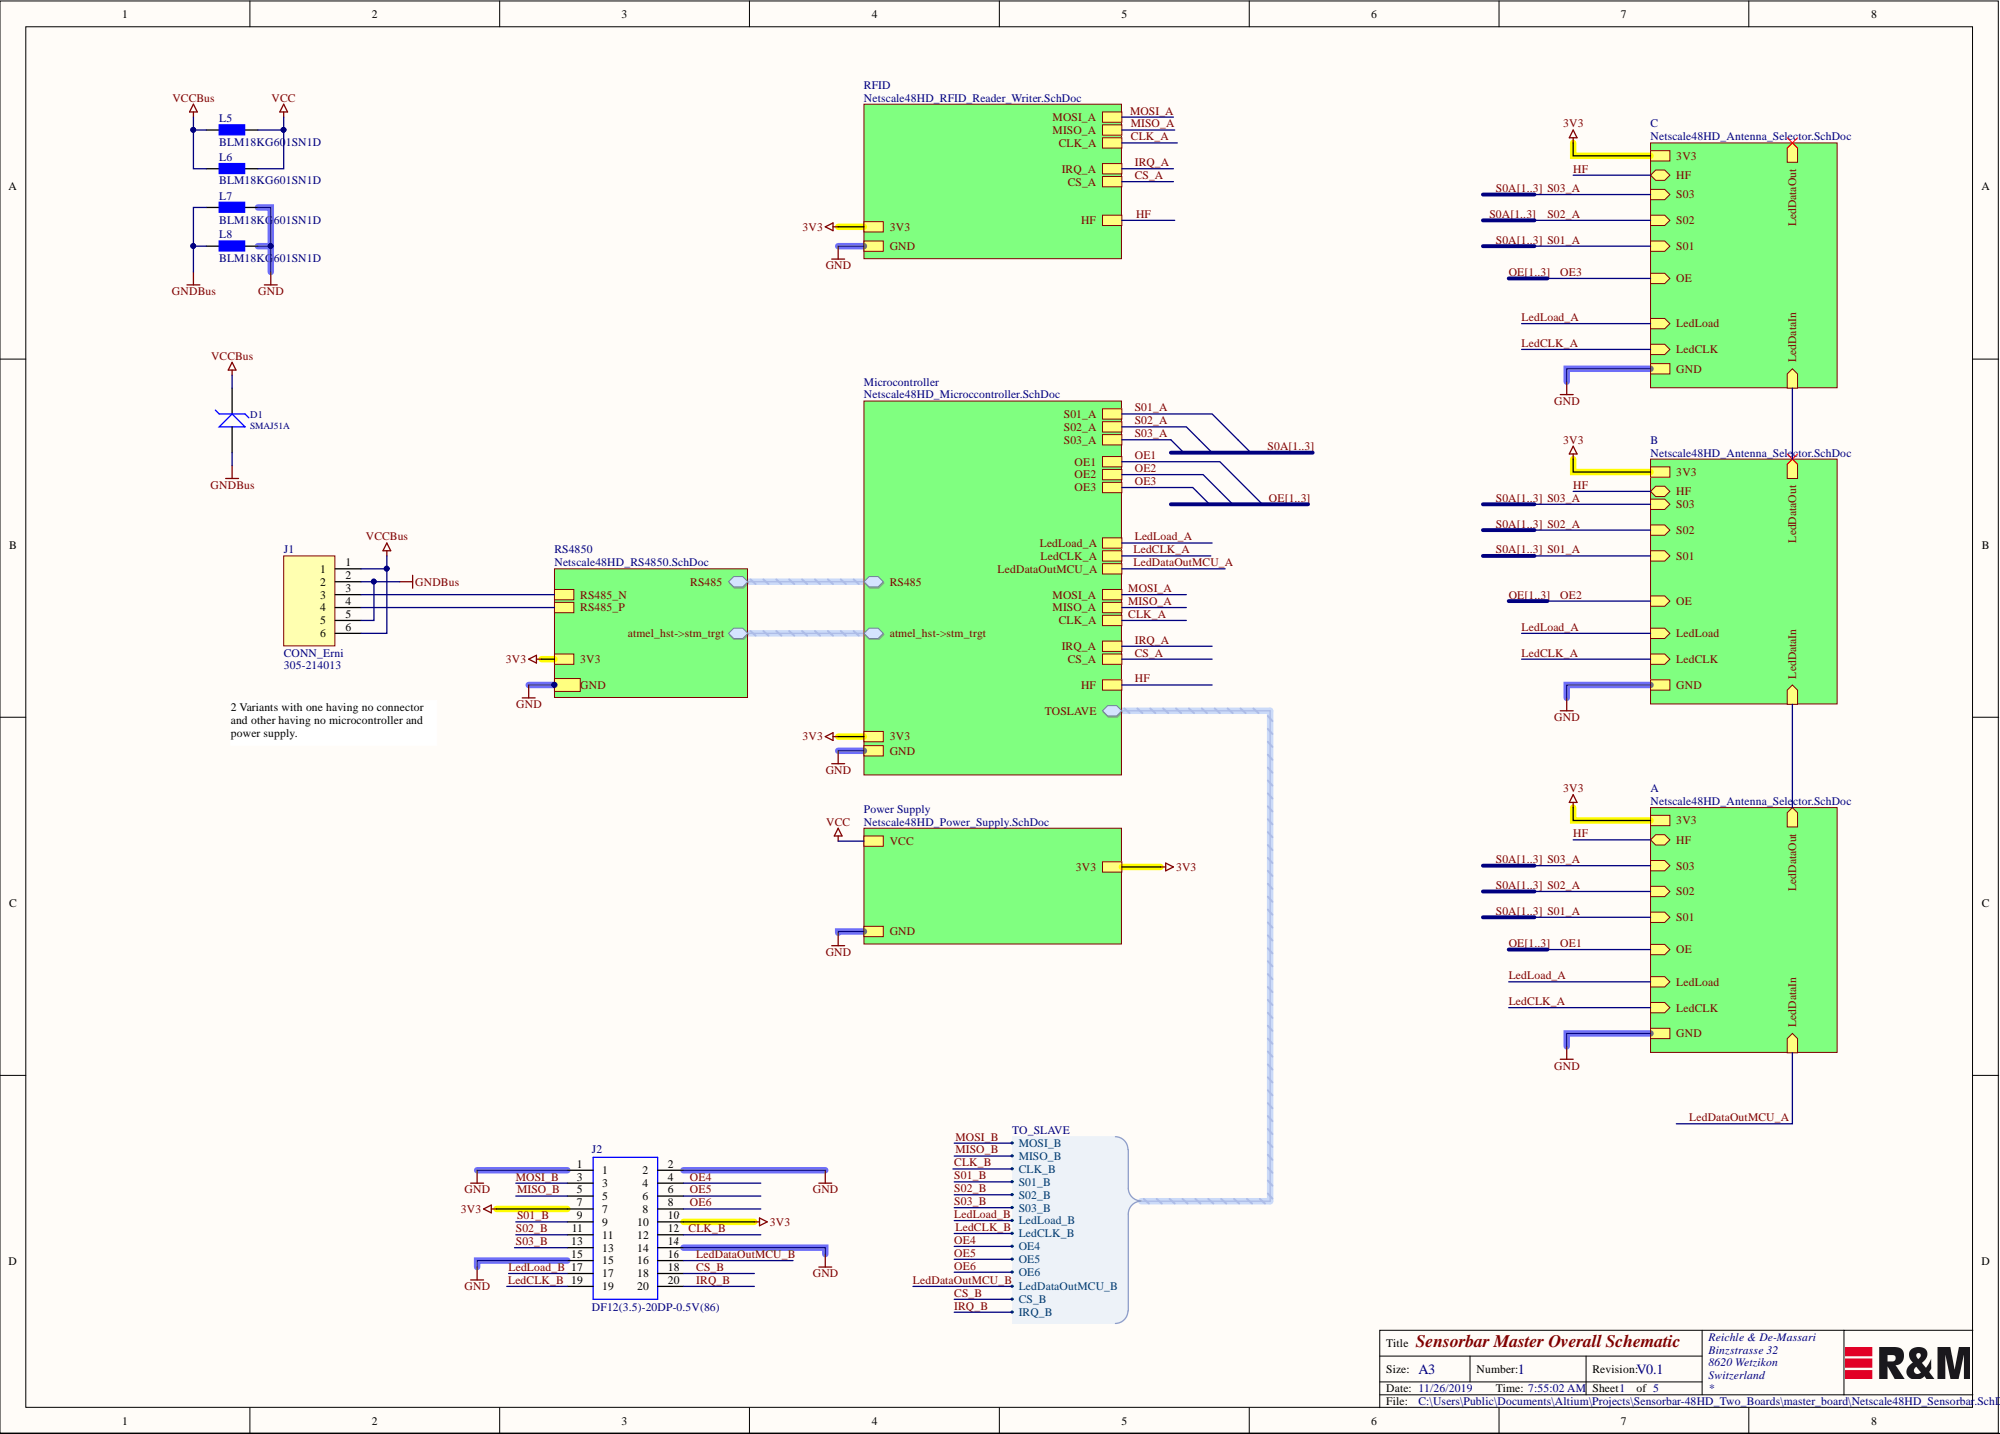
[picture p7: page 1]

2 Variants with one having no connector
and other having no microcontroller and
power supply.

Sensorbar Master Overall Schematic Title | Reichle & De-Massari Binzstrasse 32 8620 Wetzikon Switzerland *

Size: A3 | Number: 1 | Revision: V0.1
Date: 11/26/2019 Time: 7:55:02 AM | | Sheet of 5

C:\Users\Public\Documents\Altium\Projects\Sensorbar-48HD_Two_Boards\master_board\Netscale48HD_Sensorbar.SchDoc

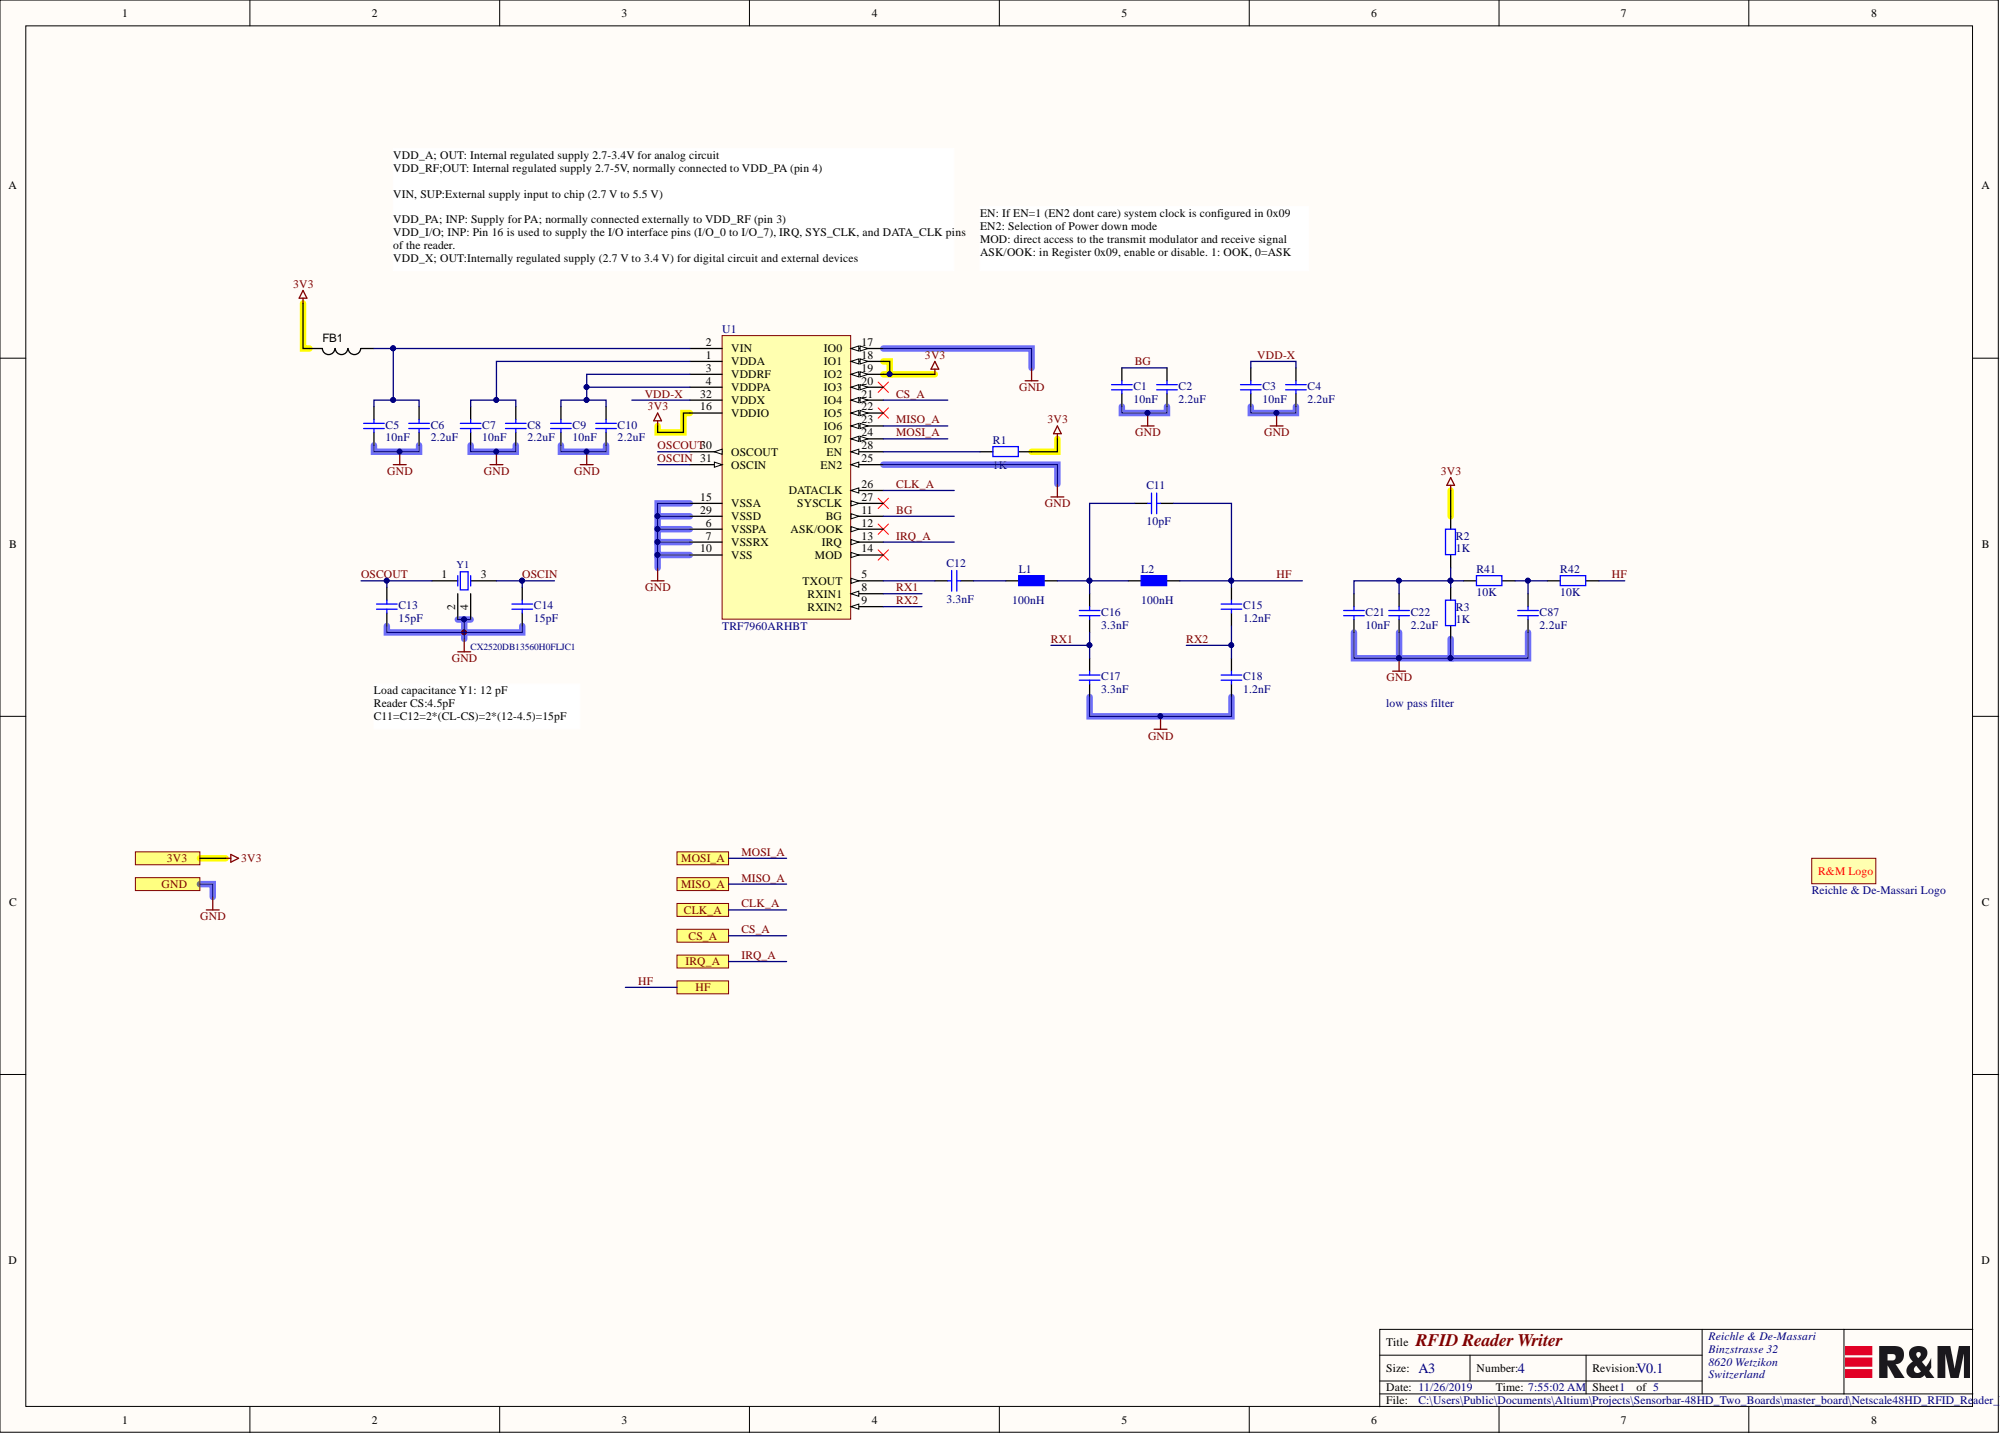
[picture p8: page 2]

VDD_A; OUT: Internal regulated supply 2.7-3.4V for analog circuit
VDD_RF;OUT: Internal regulated supply 2.7-5V, normally connected to VDD_PA (pin 4)

VIN, SUP:External supply input to chip (2.7 V to 5.5 V)

VDD_PA; INP: Supply for PA; normally connected externally to VDD_RF (pin 3)
VDD_I/O; INP: Pin 16 is used to supply the I/O interface pins (I/O_0 to I/O_7), IRQ, SYS_CLK, and DATA_CLK pins
of the reader.
VDD_X; OUT:Internally regulated supply (2.7 V to 3.4 V) for digital circuit and external devices

EN: If EN=1 (EN2 dont care) system clock is configured in 0x09
EN2: Selection of Power down mode
MOD: direct access to the transmit modulator and receive signal
ASK/OOK: in Register 0x09, enable or disable. 1: OOK, 0=ASK

VDDPA 4

VDDX 32 | GND VDD-X

VDDIO 16

R&M Logo
Reichle & De-Massari Logo

RFID Reader Writer

C:\Users\Public\Documents\Altium\Projects\Sensorbar-48HD_Two_Boards\master_board\Netscale48HD_RFID_Reader_Writer.SchDoc

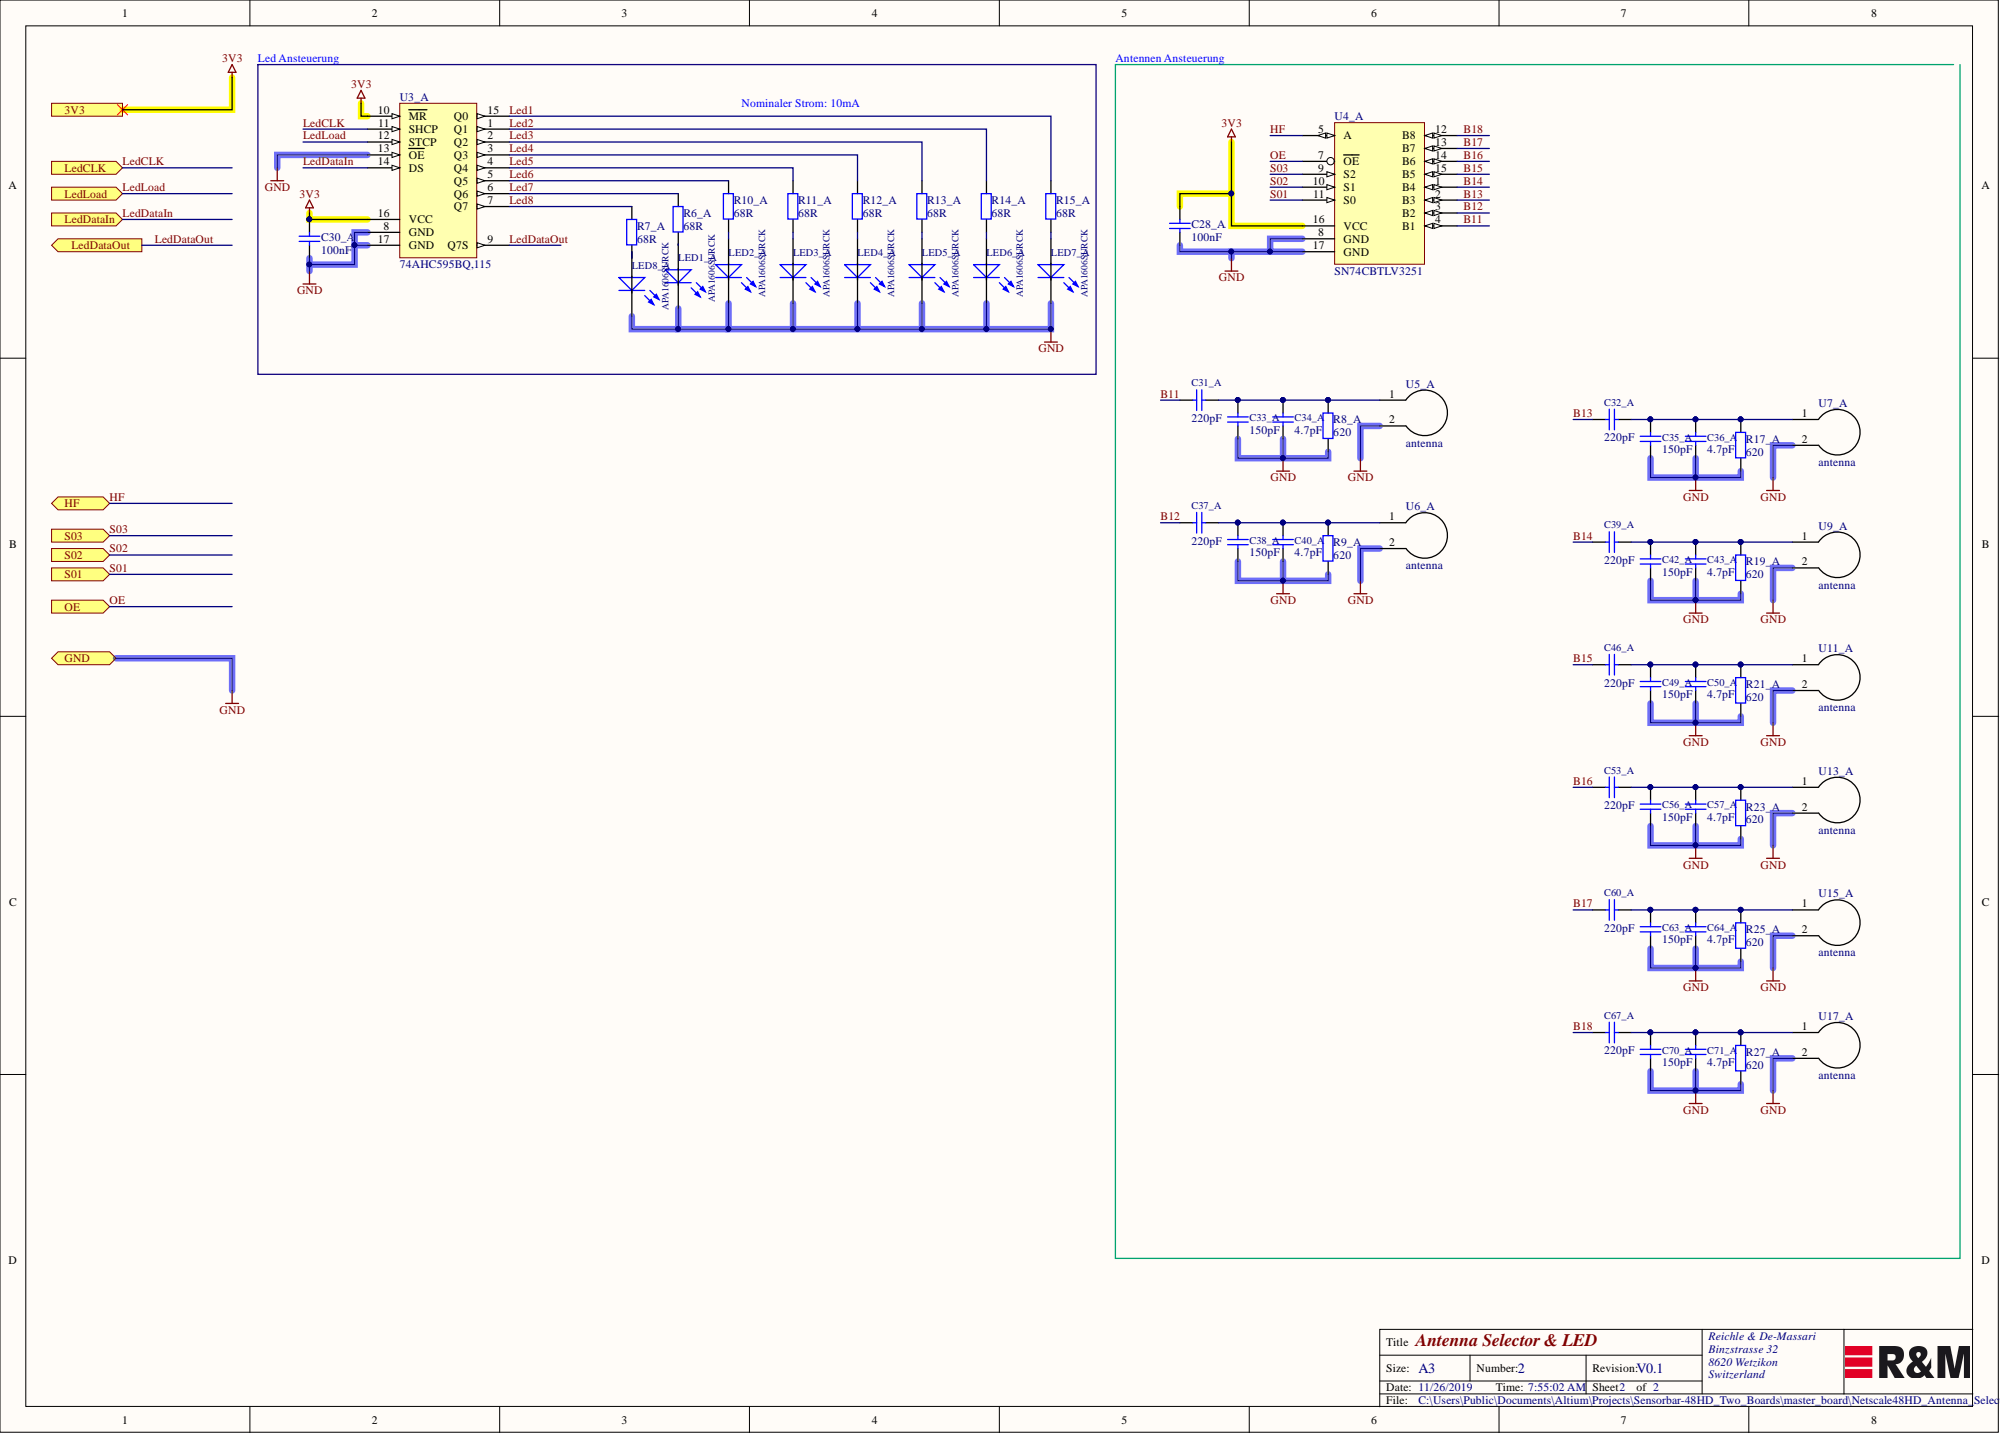
[picture p9: page 3]

Led DataIn | 1 4 | | 4 | Led 5
V 3 1 6 | | 5 | Led 6

6 Led 7

T e | Reich le & De-Ma s a r i B n z t se 3 0 Wetz iko Swi tzer l d

Size: | N umber: | Rev V

/ ime: : A M | | Sheet f

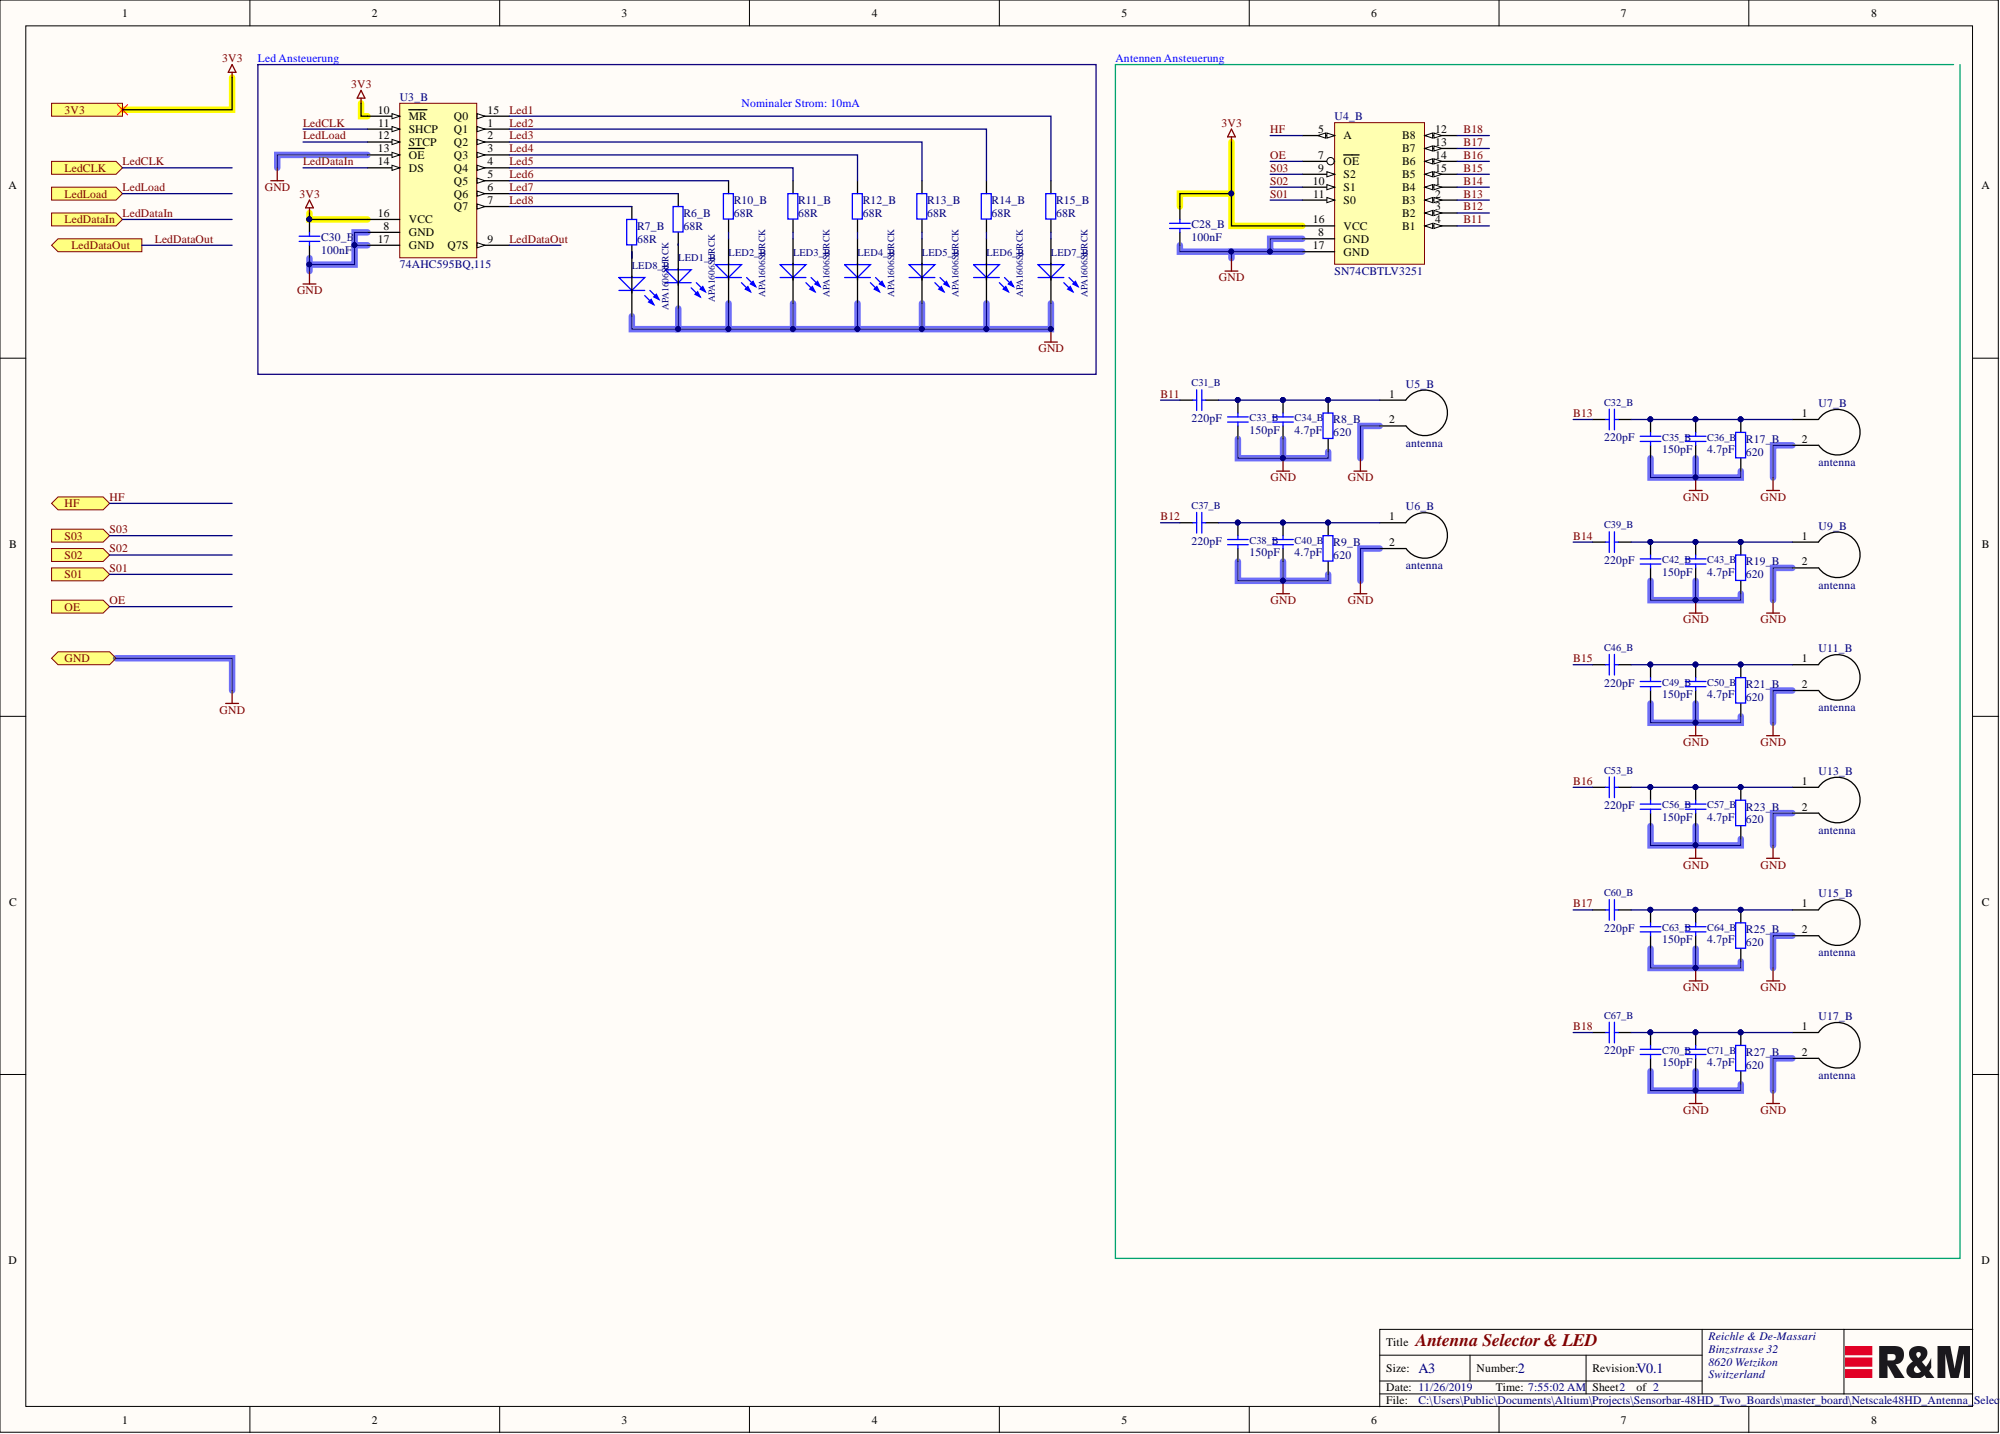
[picture p10: page 4]

Led DataIn | 1 4 | | 4 | Led 5
V 3 1 6 | | 5 | Led 6

6 Led 7

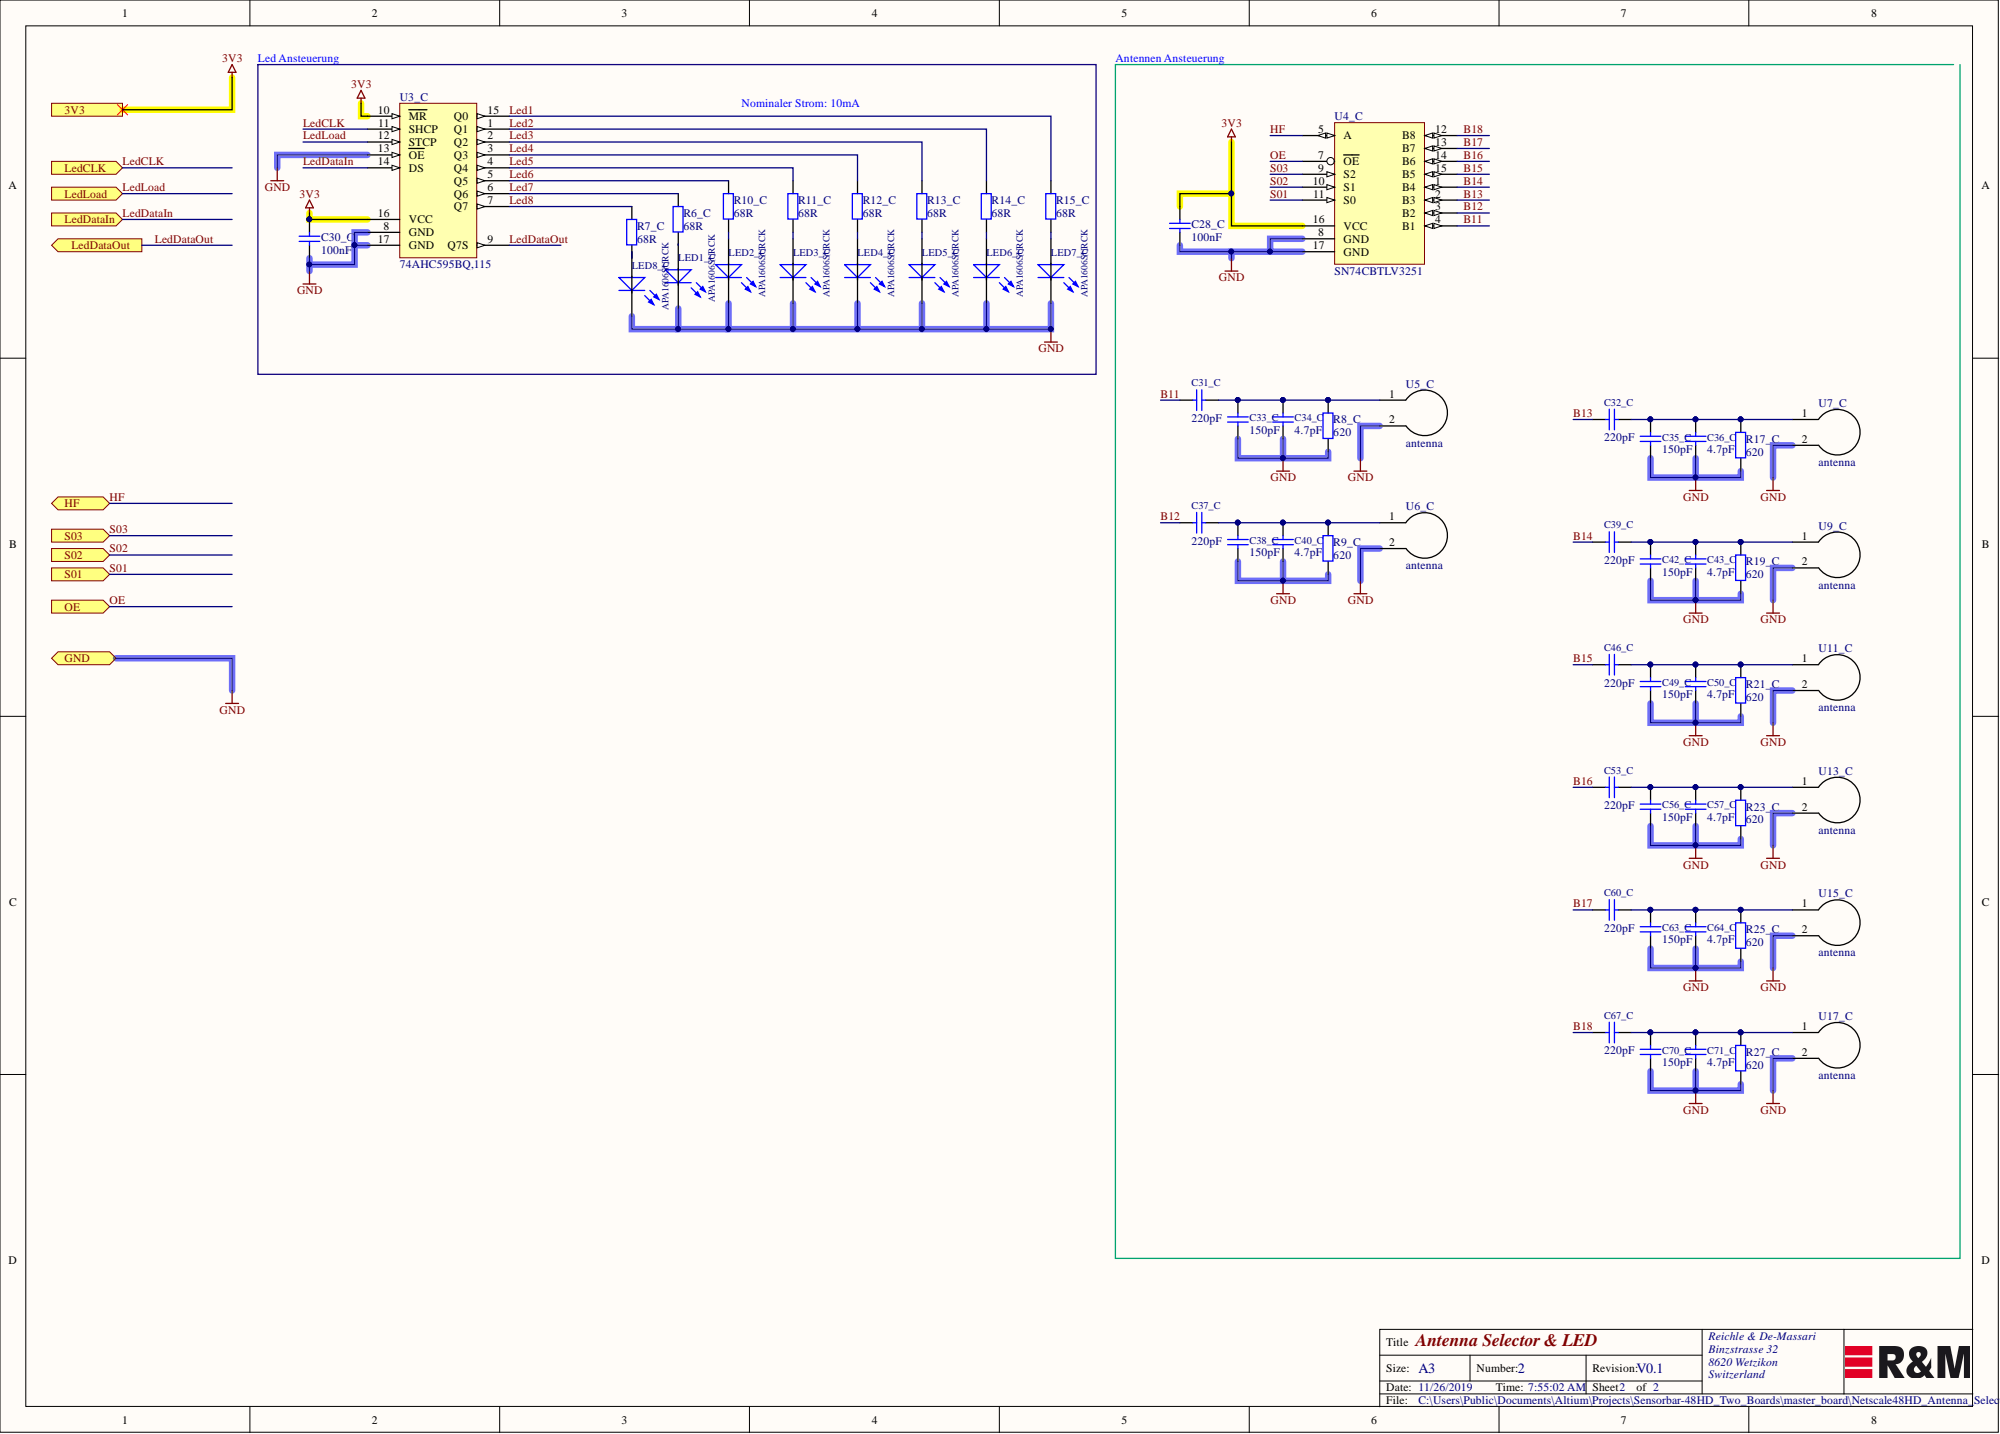
[picture p11: page 5]

Led DataIn | 1 4 | | 4 | Led 5
V 3 1 6 | | 5 | Led 6

6 Led 7

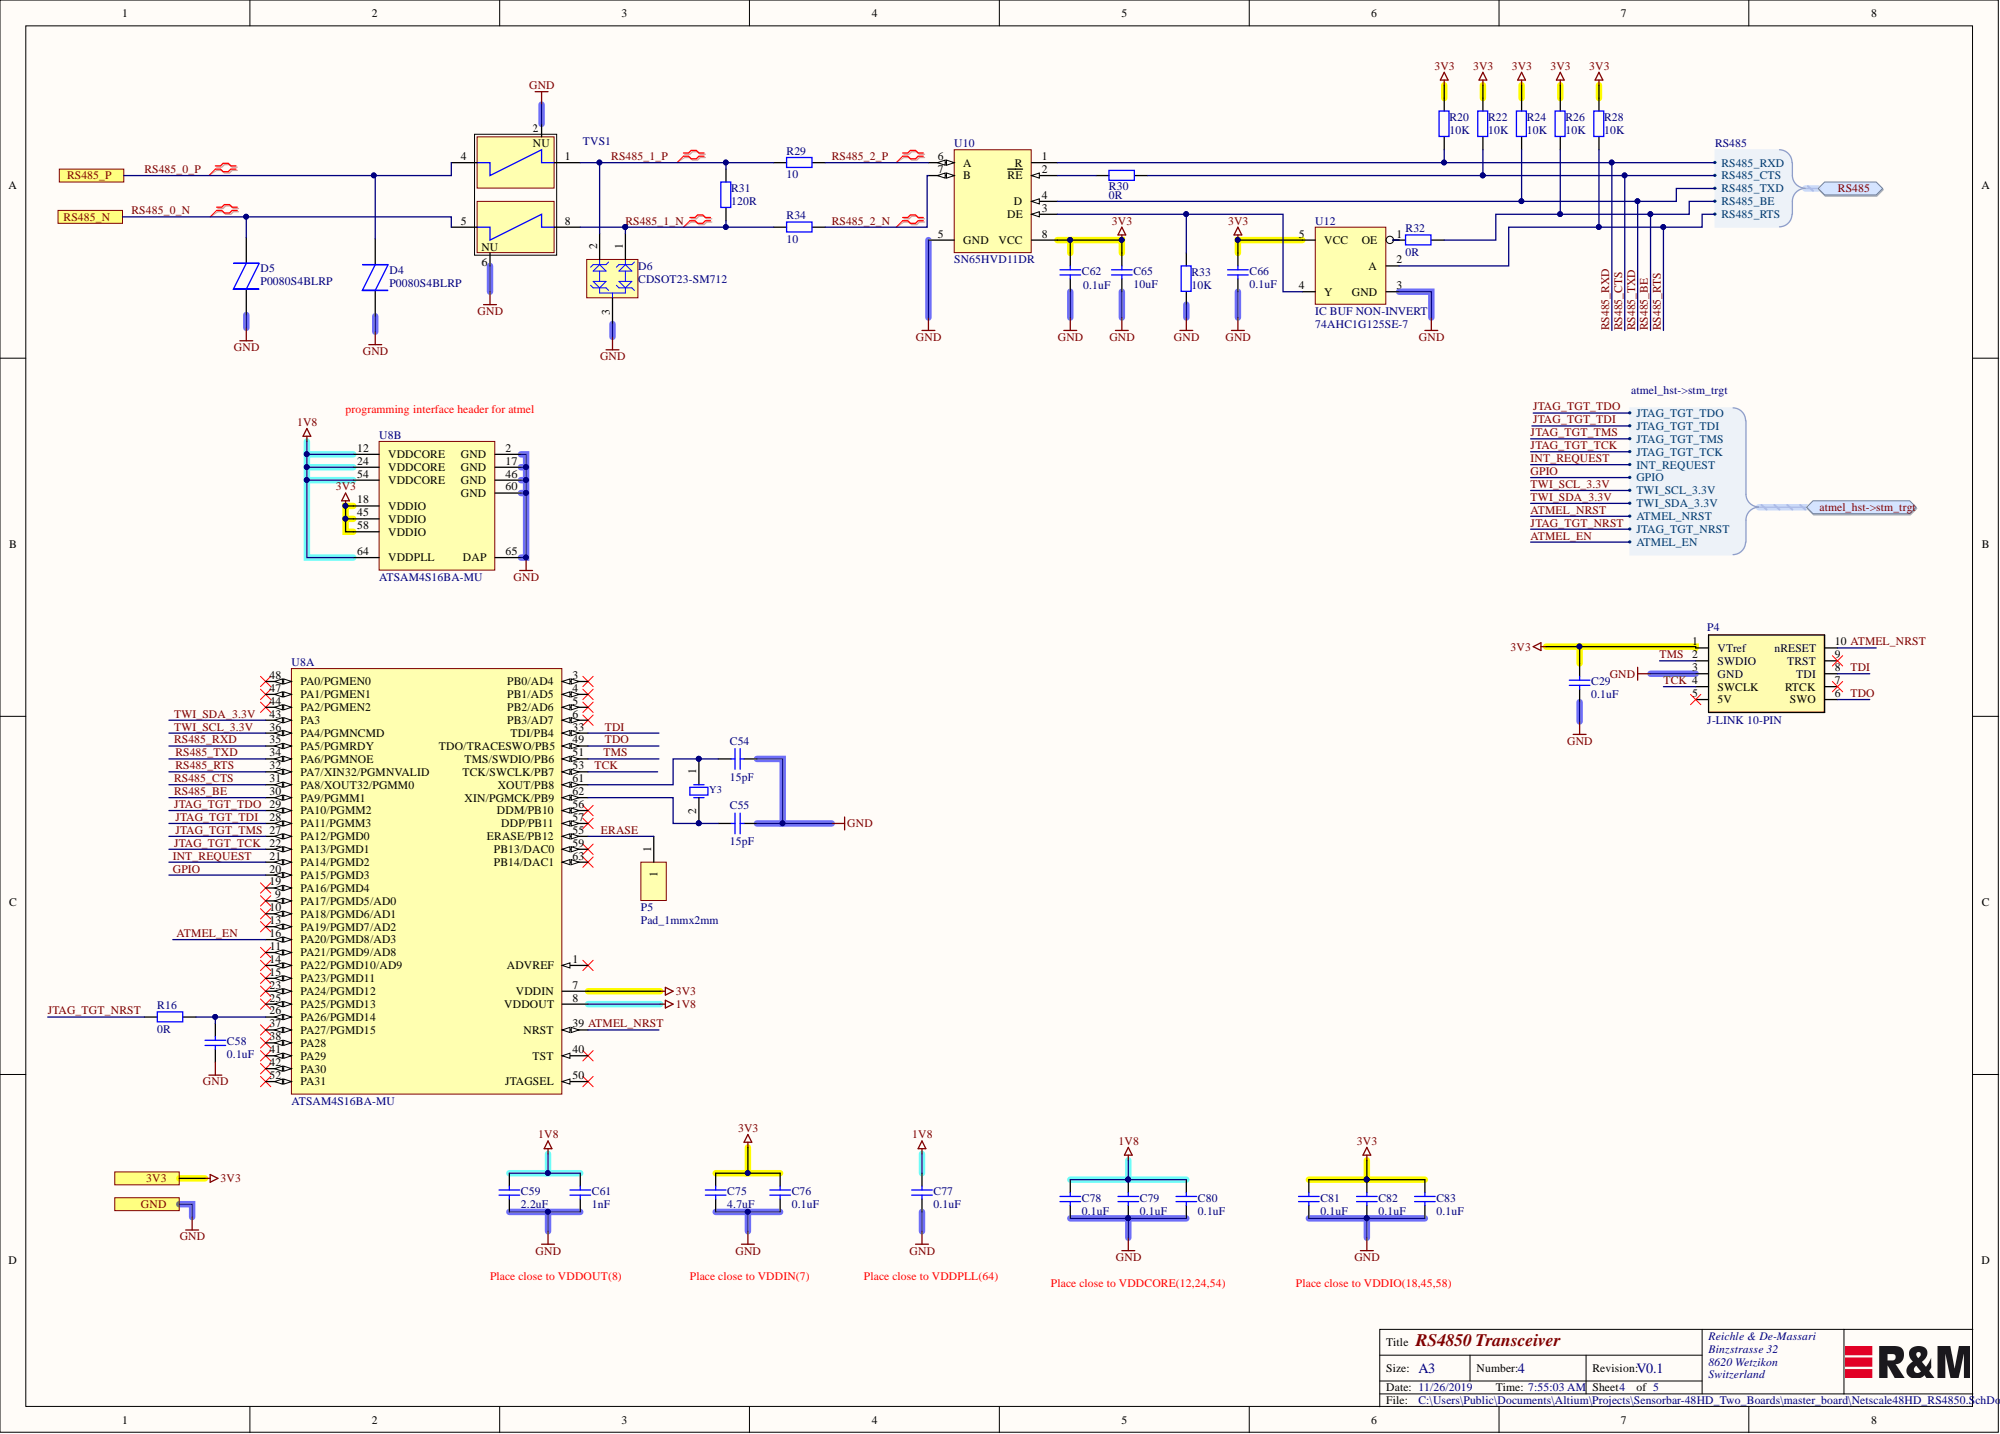
[picture p12: page 6]

IC BUF NON-INVERT
74AHC1G125SE-7

programming interface header for atmel

Place close to VDDOUT(8)

Place close to VDDIN(7)

Place close to VDDPLL(64)

Place close to VDDCORE(12,24,54)

Place close to VDDIO(18,45,58)

RS4850 Transceiver

C:\Users\Public\Documents\Altium\Projects\Sensorbar-48HD_Two_Boards\master_board\Netscale48HD_RS4850.SchDoc

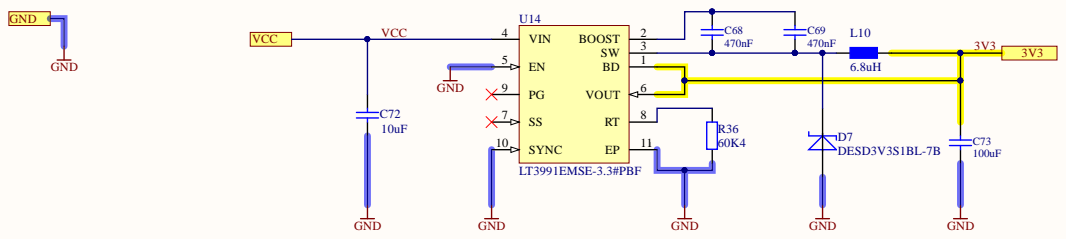
[picture p13: page 7]

Power Supply | *

C:\Users\Public\Documents\Altium\Projects\Sensorbar-48HD_Two_Boards\master_board\Netscale48HD_Power_Supply.SchDoc

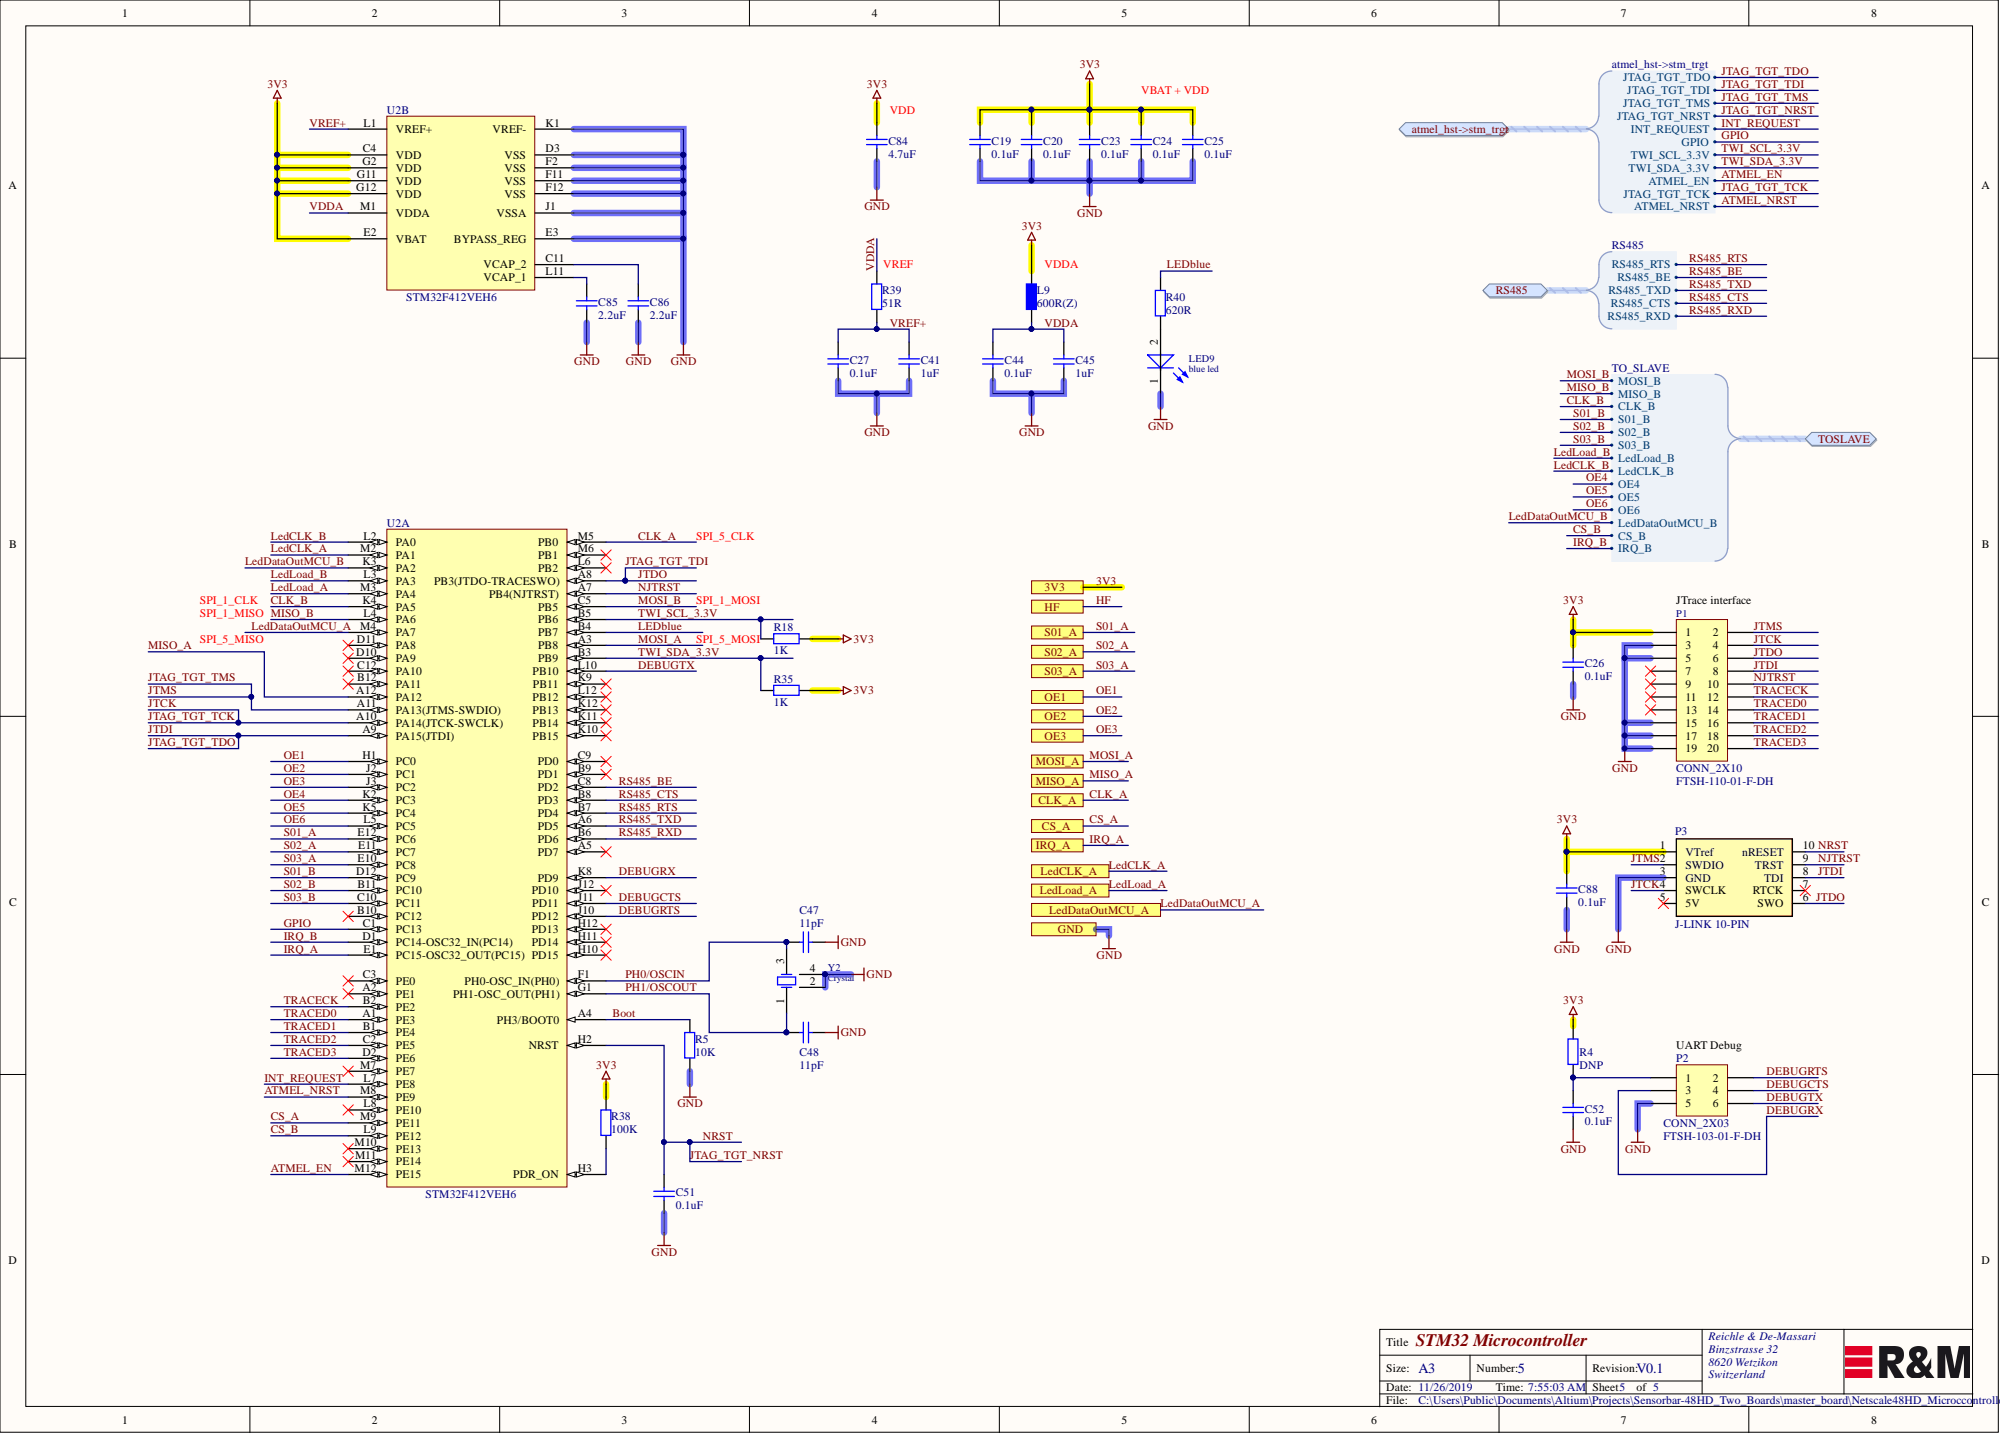
[picture p14: page 8]

TRACECK TRACED0 TRACED1 TRACED2 TRACED3 JTMS JTCK JTDI JTDO NJTRST DEBUGRT

J TMS
J TCK | A 1 1

NRST NJTRST JTDI JTDO
