atthorv/Sensobar-48HD_6L/slave_board/Project Outputs for Netscale48HD_Sensorbar/Assembly_Drawings_S.PDF

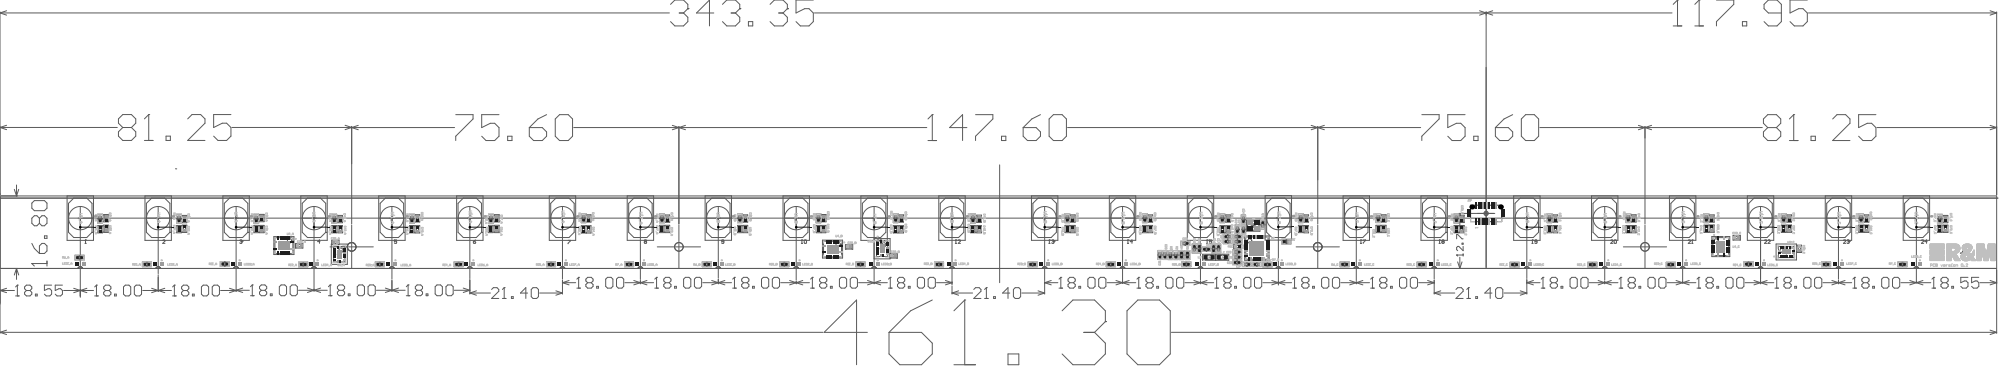
[picture p15: page 1]

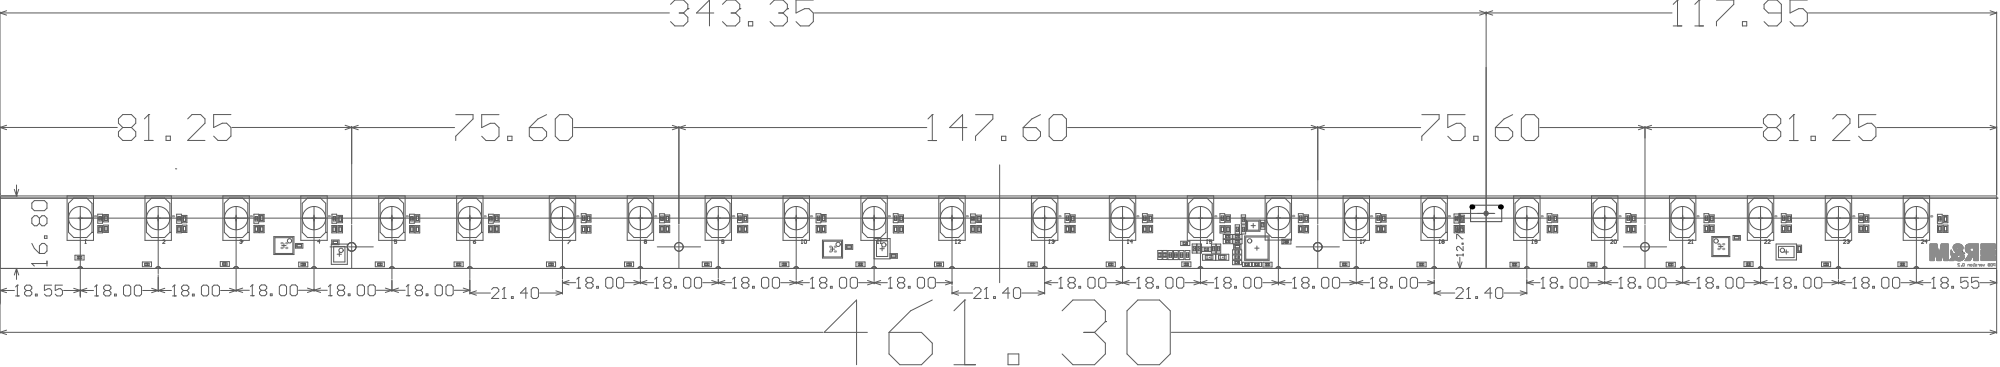
[picture p16: page 2]

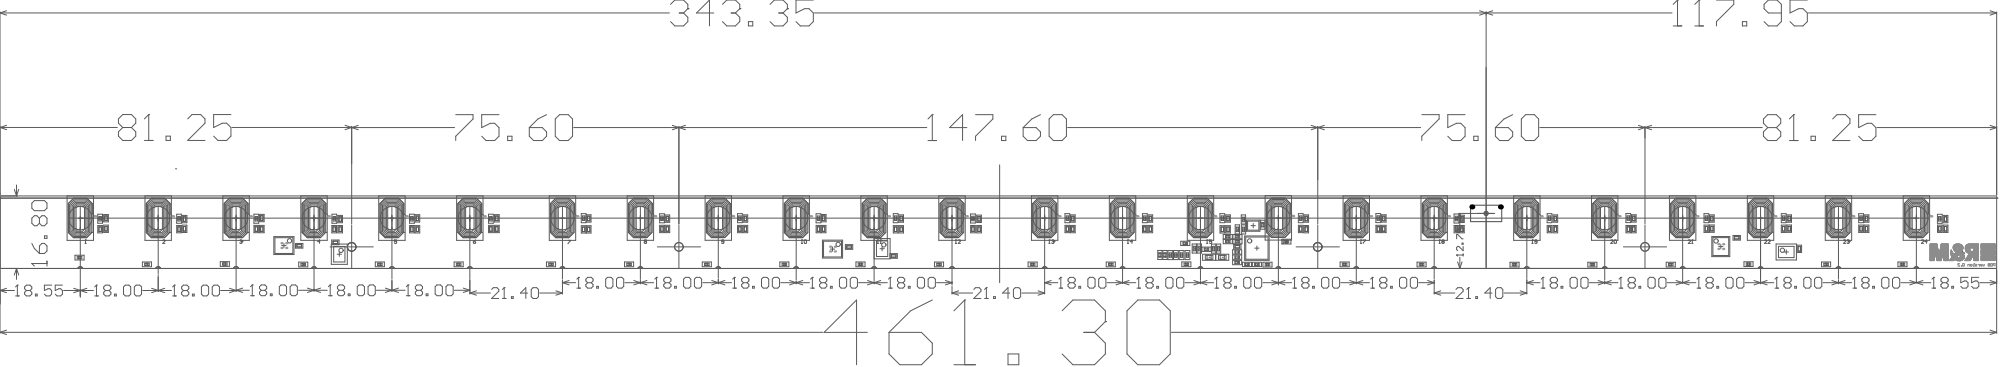
[picture p17: page 4]
