atthorv/Sensobar-48HD_6L/master_board/Project Outputs for Netscale48HD_Sensorbar/Assembly_Drawings_M.PDF

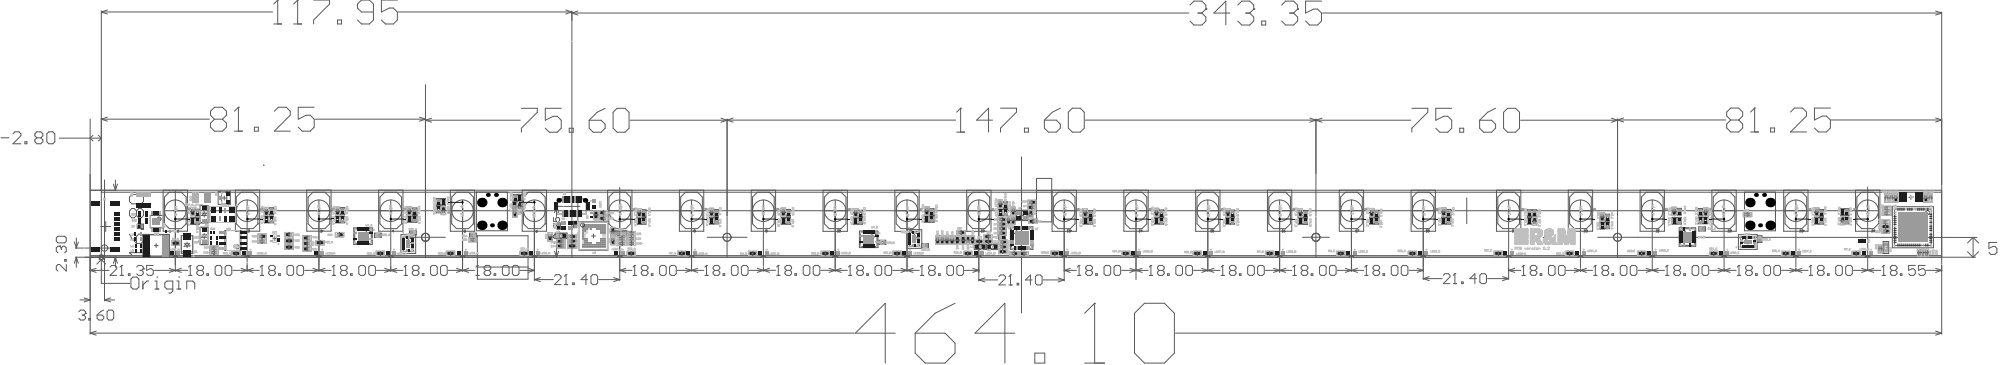
[picture p18: page 1]

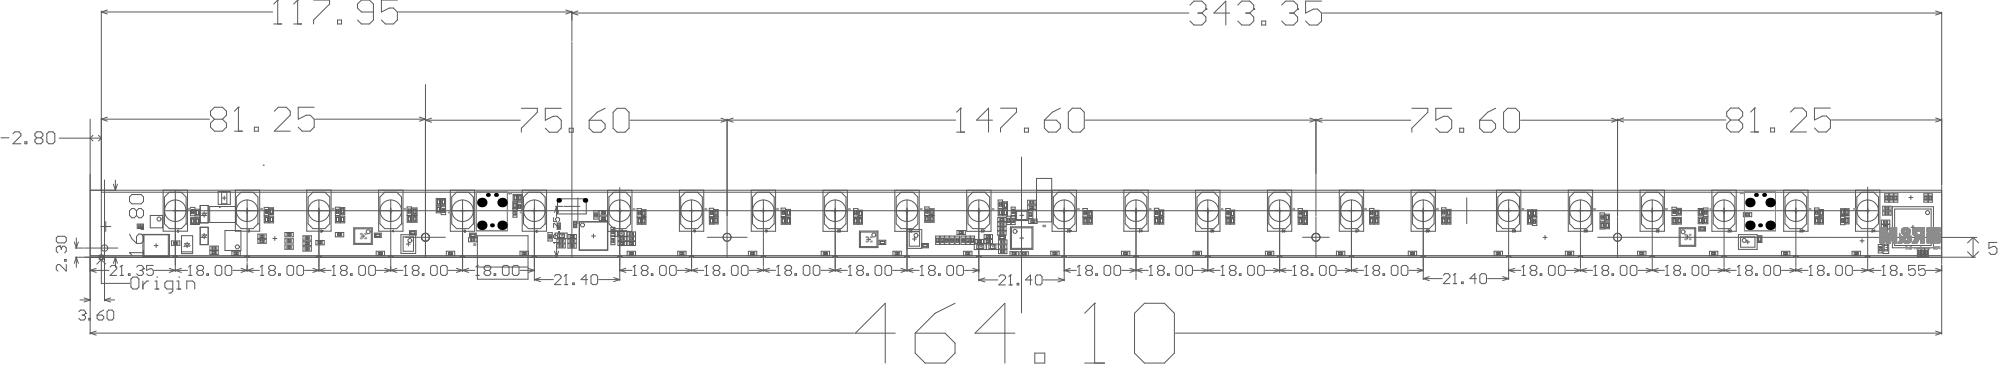
[picture p19: page 2]

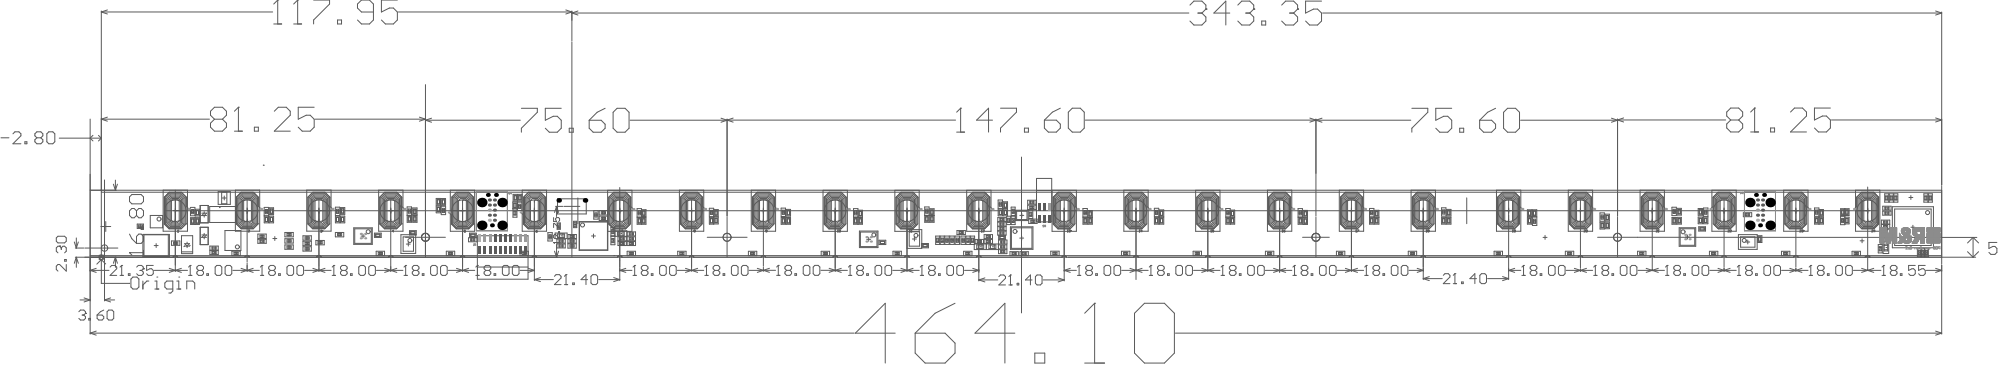
[picture p20: page 4]
