atthorv/Sensobar-48HD_6L/slave_board/Project Outputs for Netscale48HD_Sensorbar/Top_Layer_S.PDF

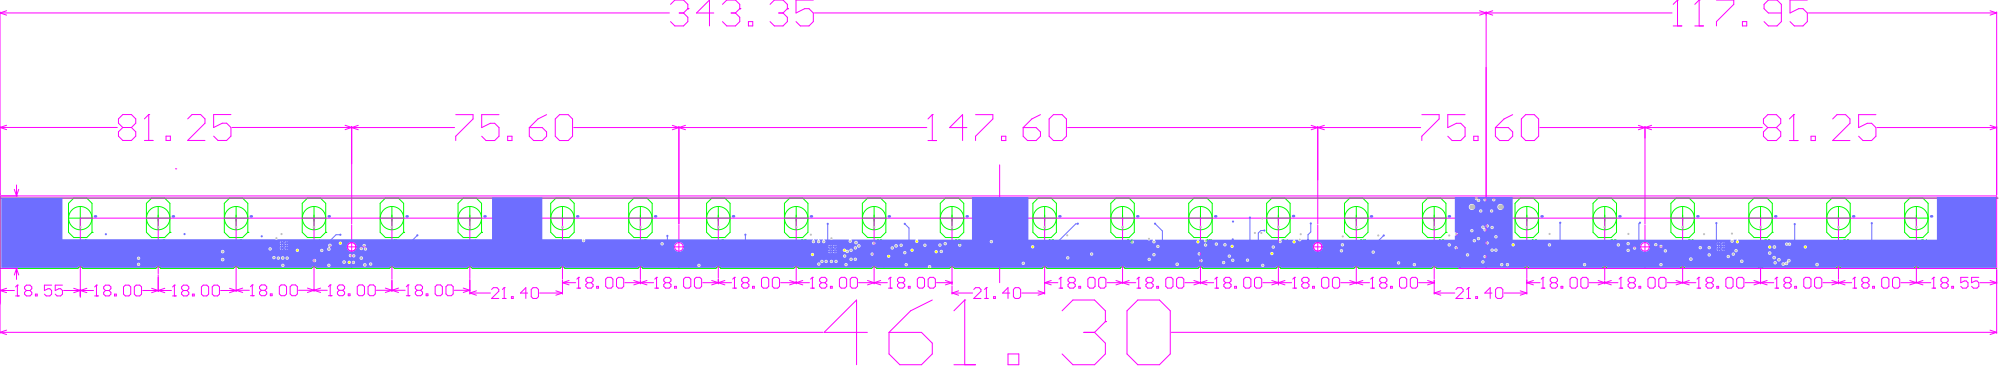
[picture p21: page 1]
