atthorv/Sensobar-48HD_6L/master_board/Project Outputs for Netscale48HD_Sensorbar/Top_Layer_M.PDF

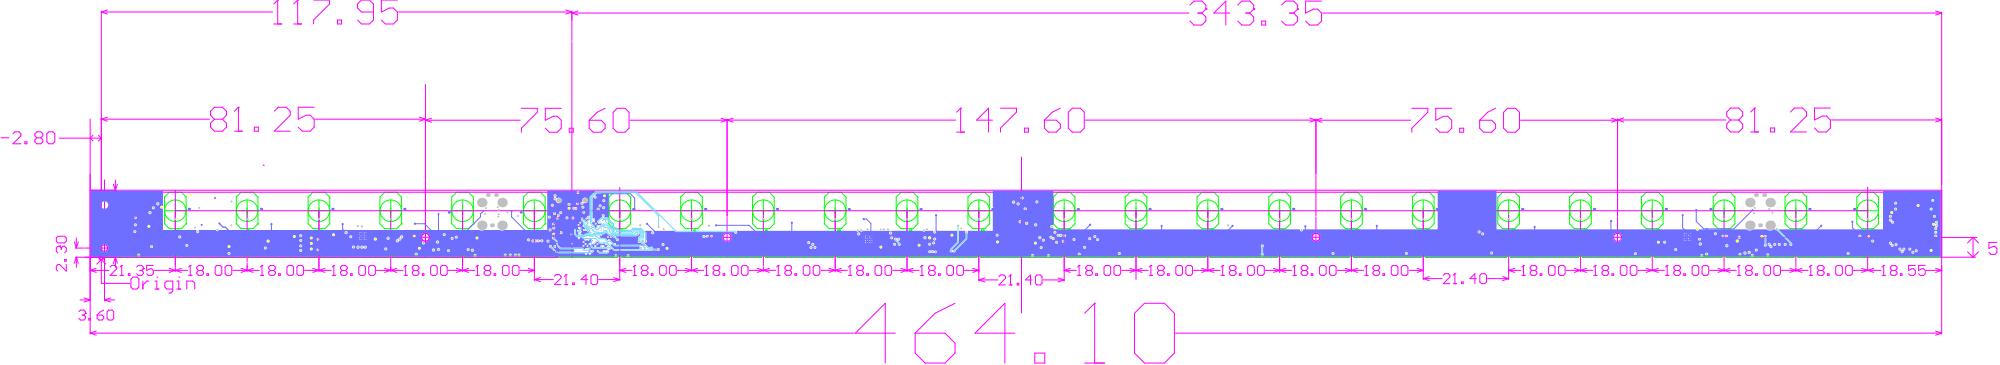
[picture p22: page 1]
