atthorv/Sensobar-48HD_6L/master_board/Project Outputs for Netscale48HD_Sensorbar/Layers/Bottom_Layer.PDF

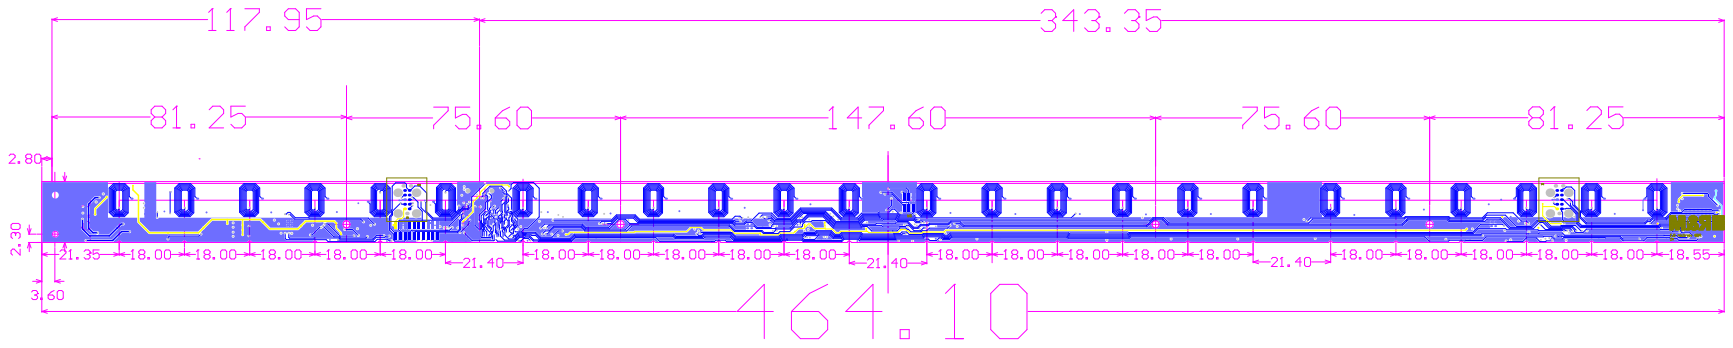
[picture p23: page 1]
