atthorv/Sensobar-48HD_6L/master_board/Project Outputs for Netscale48HD_Sensorbar/Layers/Midlayer1.PDF

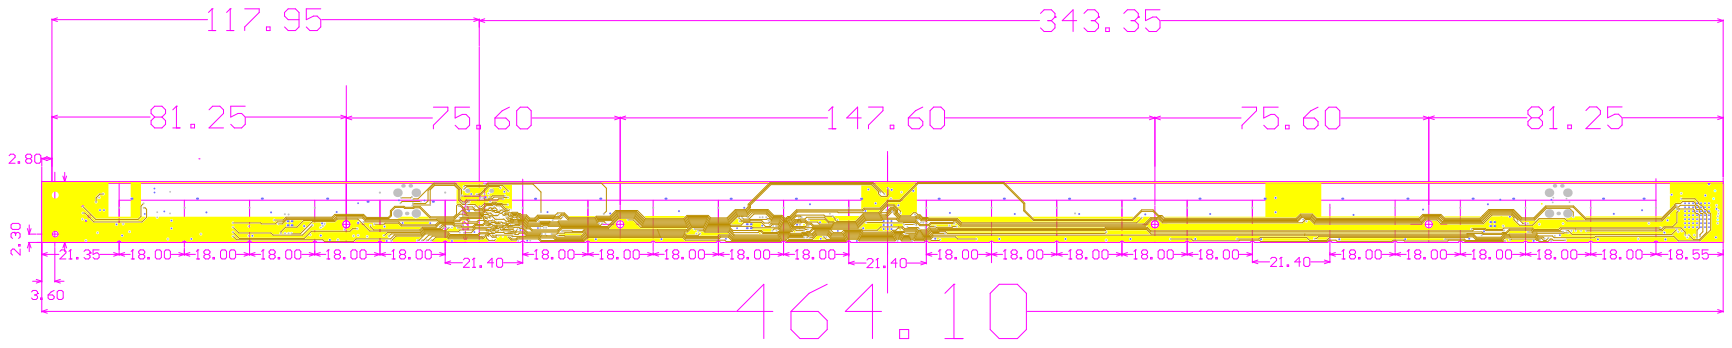
[picture p24: page 1]
