atthorv/Sensobar-48HD_6L/master_board/Project Outputs for Netscale48HD_Sensorbar/Layers/Midlayer2.PDF

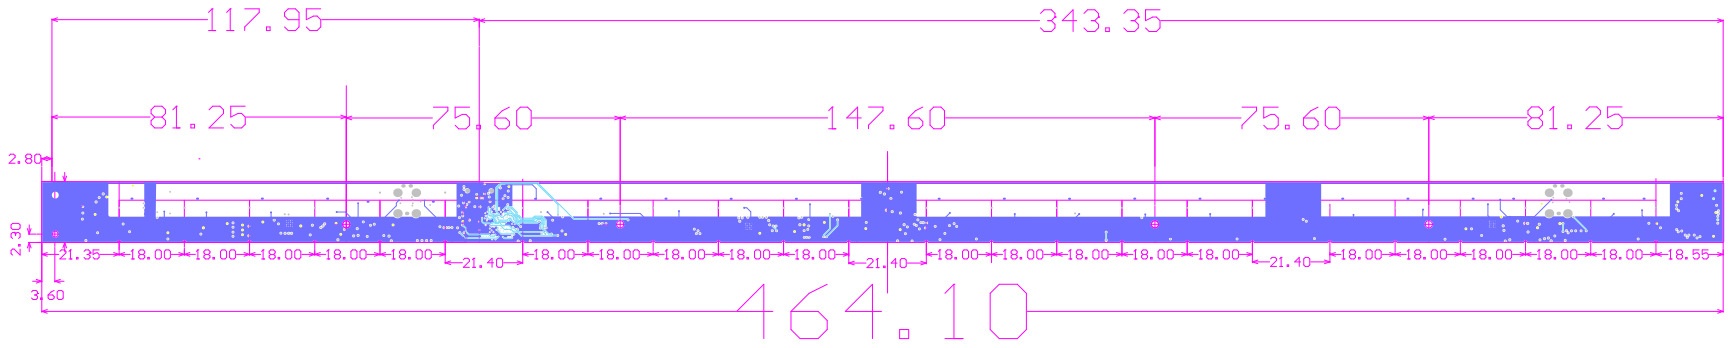
[picture p25: page 1]
