atthorv/Sensobar-48HD_6L/master_board/Project Outputs for Netscale48HD_Sensorbar/Layers/Top_Layer.PDF

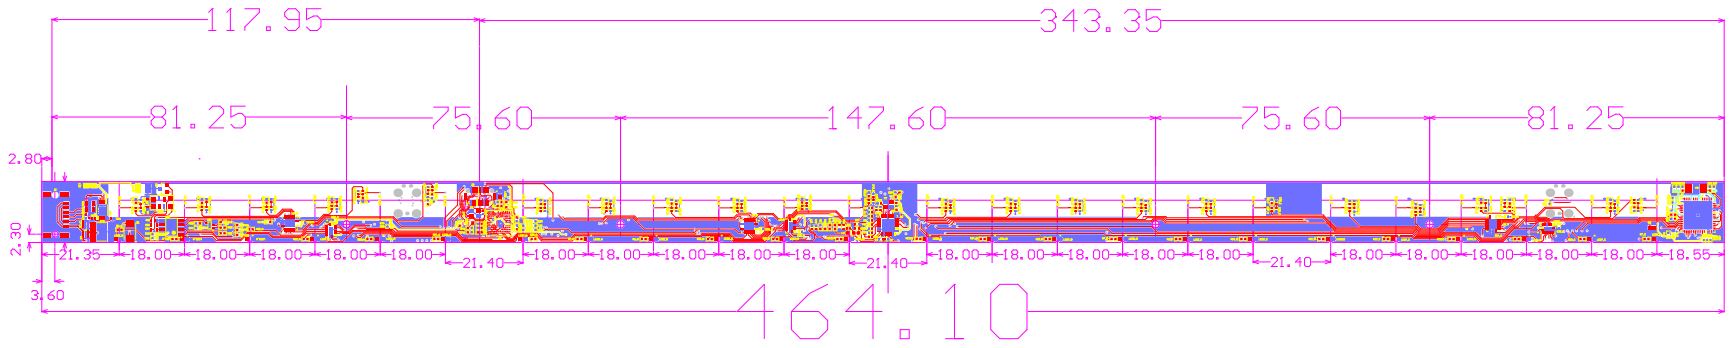
[picture p26: page 1]
