atthorv/Sensobar-48HD_6L/(list of files, drawings)

Other design files:
master_board/Microccontroller.SchDoc
master_board/Netscale48HD_Antenna_Selector.SchDoc
master_board/Netscale48HD_Microccontroller.SchDoc
master_board/Netscale48HD_Power_Supply.SchDoc
master_board/Netscale48HD_RFID_Reader_Writer.SchDoc
master_board/Netscale48HD_RS4850.SchDoc
master_board/Netscale48HD_Sensorbar.PrjPcb
master_board/Netscale48HD_Sensorbar.SchDoc
master_board/RDM_ALT_SCH.SchLib
slave_board/Board_Connector.SchDoc
slave_board/Netscale48HD_Antenna_Selector.SchDoc
slave_board/Netscale48HD_Sensorbar.SchDoc
slave_board/Netscale48HD_Sensorbar_Slave.PrjPcb
slave_board/RDM_ALT_SCH.SchLib
slave_board/RFID_Reader_Writer.SchDoc
