atthorv/Sensobar-48HD_6L/(commit log)

2019-11-26 First commit of Sensorbar-48HD_6L version 0.2
    [BOM_M.xls, Microccontroller.SchDoc, Netscale48HD_Antenna_Selector.SchDoc, Netscale48HD_Microccontroller.SchDoc, Netscale48HD_Power_Supply.SchDoc, Netscale48HD_RFID_Reader_Writer.SchDoc, Netscale48HD_RS4850.SchDoc, Netscale48HD_Sensorbar.PrjPcb]
2019-11-26 Resolved Board cutout issue
    [Netscale48HD_Sensorbar_Slave.GBL, Netscale48HD_Sensorbar_Slave.GKO, Netscale48HD_Sensorbar_Slave.GTL]
